GanzingerLab/K2TIRF/K2TIRF/images/K2_setup_left.jpg

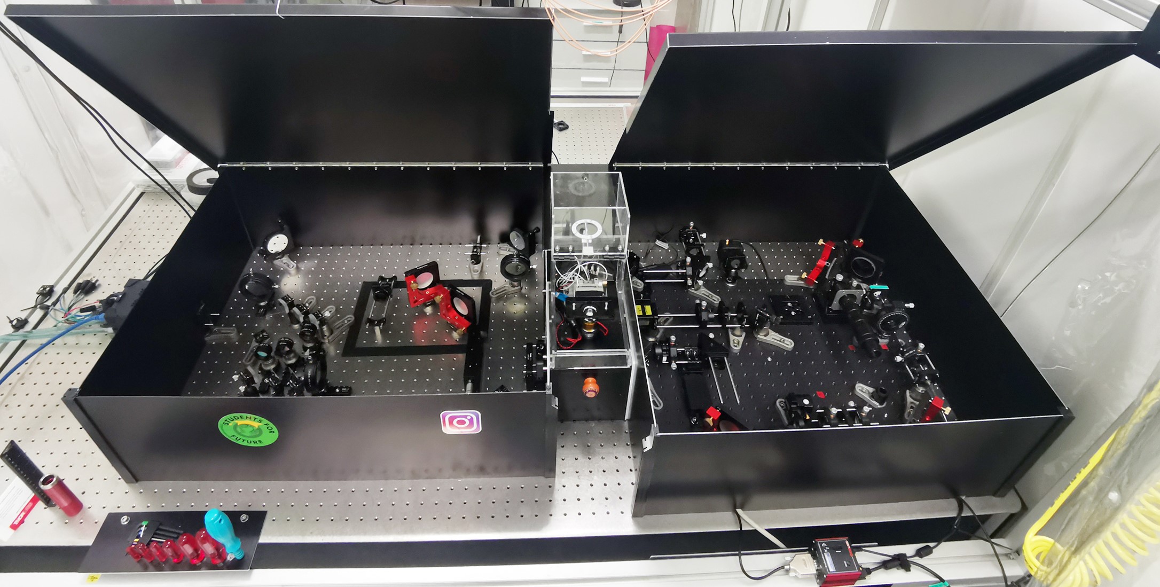
K2TIRF/images/K2_setup_left.jpg
