GanzingerLab/K2TIRF/K2TIRF/images/slideshow/fullsetup.jpg

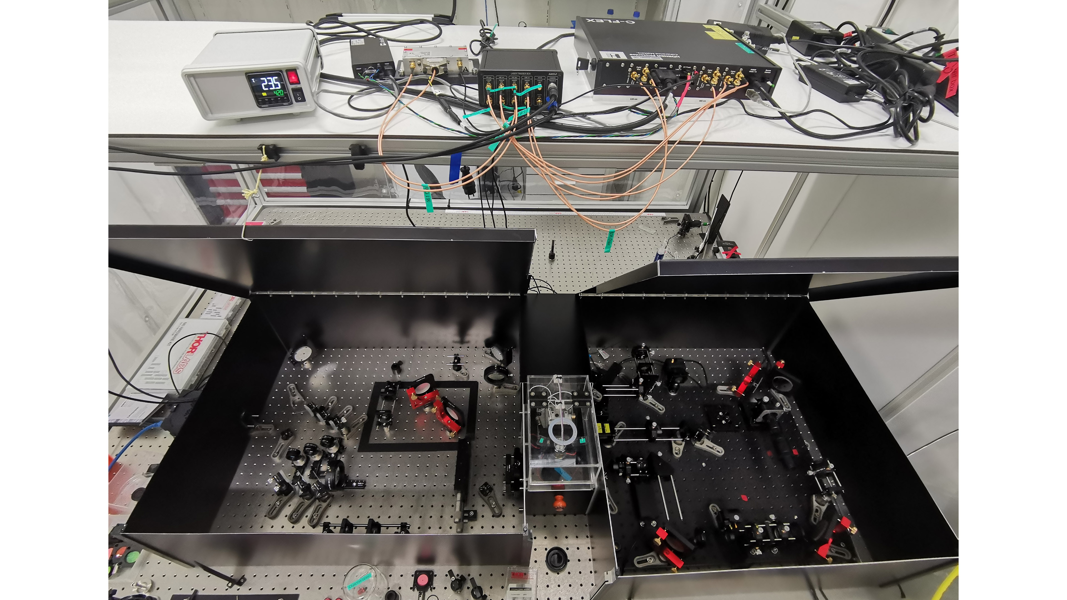
K2TIRF/images/slideshow/fullsetup.jpg
