GanzingerLab/K2TIRF/Readme.md

Home of the K2 TIRF GithubPages documents. See the site in action on https://ganzingerlab.github.io/K2TIRF/index.html.
