GanzingerLab/K2TIRF/K2TIRF/documentation/qgFocus/timer configuration.pdf

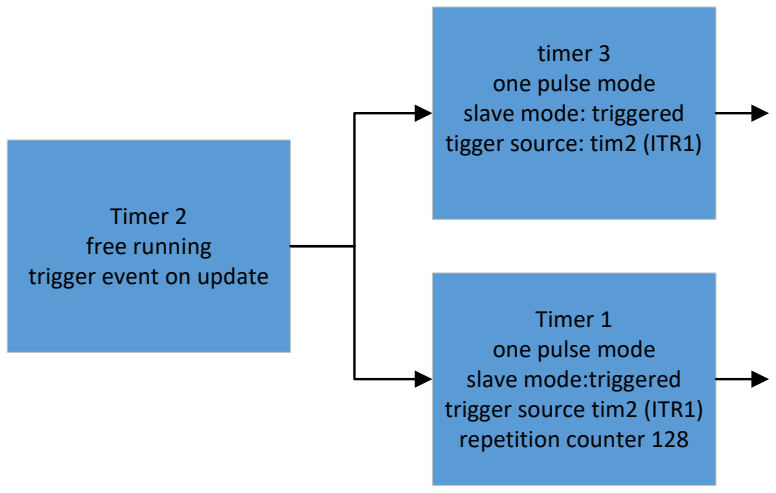
[picture p3: figure]
timer 3 one pulse mode slave mode: triggered tigger source: tim2 (ITR1); Timer 1 one pulse mode slave mode:triggered trigger source tim2 (ITR1) repetition counter 128; Timer 2 free running trigger event on update

SI

CLK

Timer 2 is free running and serves as the aquisition timer. Upon overflow of this timer, timer 3 and 1 are both triggered. Timer 3 provides the necessary SI signal for the sensor. This SI pulse is clocked through the sensors shift register by the CLK signal generated by timer 1.
