GanzingerLab/K2TIRF/K2TIRF/documentation/qgFocus/block_diagram.PNG

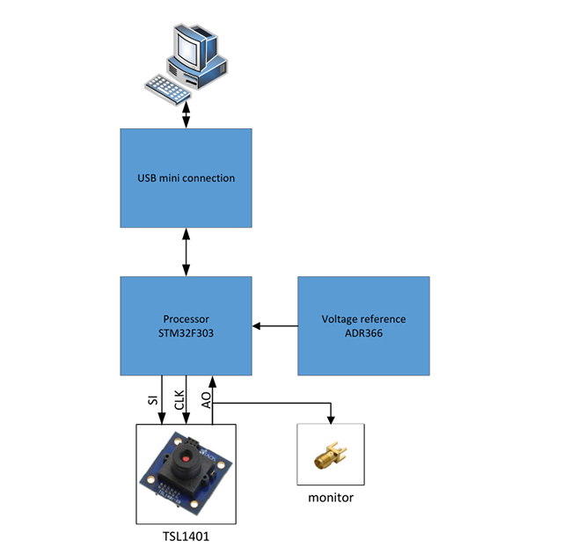
K2TIRF/documentation/qgFocus/block_diagram.PNG
