GanzingerLab/K2TIRF/K2TIRF/documentation/qgFocus/pcb.PNG

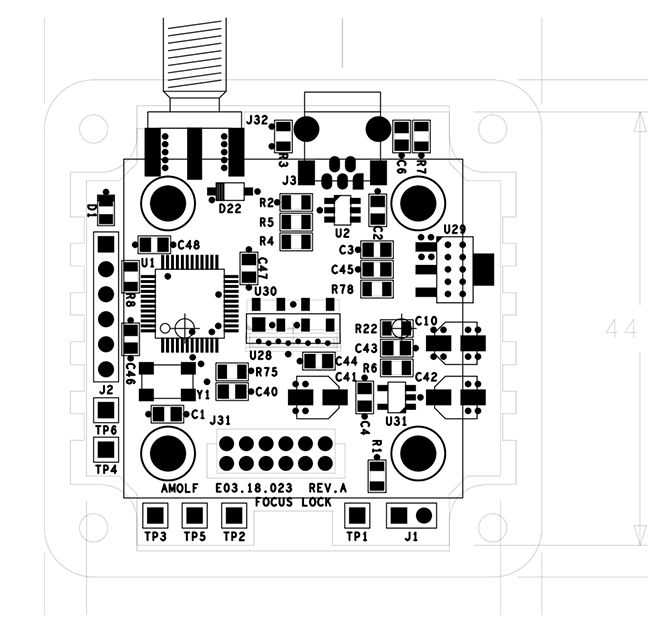
K2TIRF/documentation/qgFocus/pcb.PNG
