GanzingerLab/K2TIRF/K2TIRF/documentation/qgFocus/schematic.PNG

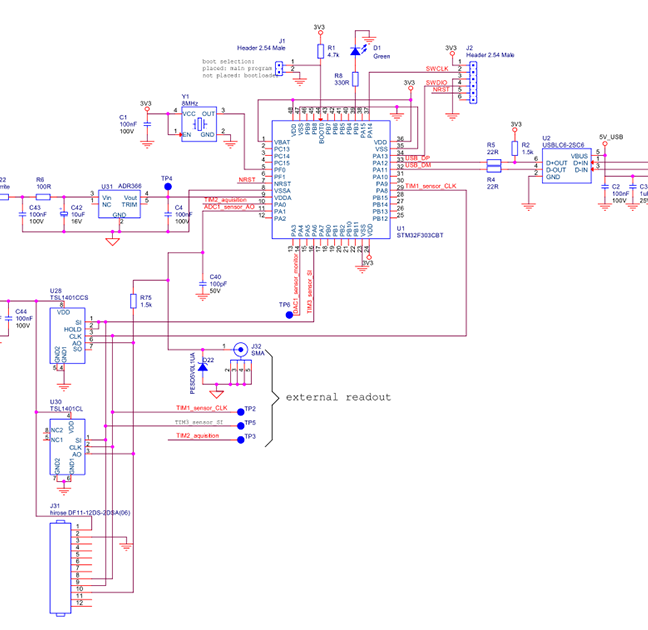
K2TIRF/documentation/qgFocus/schematic.PNG
