GanzingerLab/K2TIRF/K2TIRF/filter/box.jpg

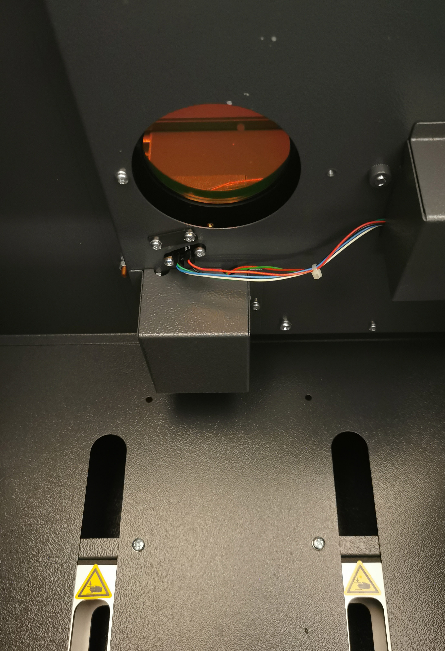
K2TIRF/filter/box.jpg
