GanzingerLab/K2TIRF/K2TIRF/filter/box_filter.jpg

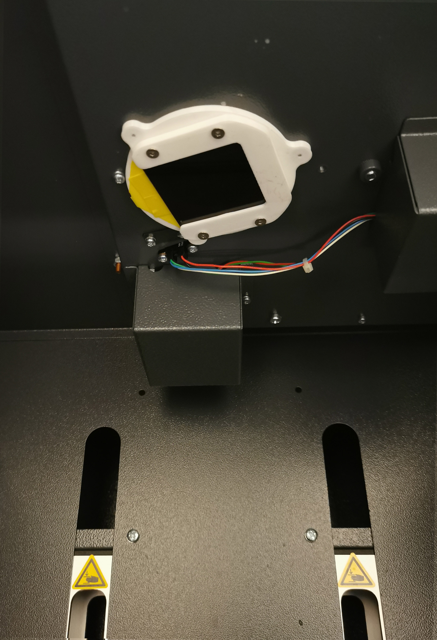
K2TIRF/filter/box_filter.jpg
