GanzingerLab/K2TIRF/K2TIRF/filter/filter.jpg

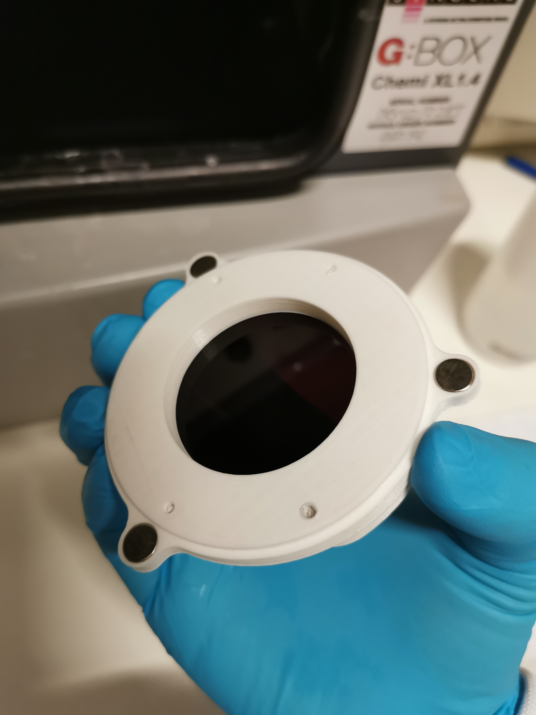
K2TIRF/filter/filter.jpg
