GanzingerLab/K2TIRF/K2TIRF/images/4fsystem.jpg

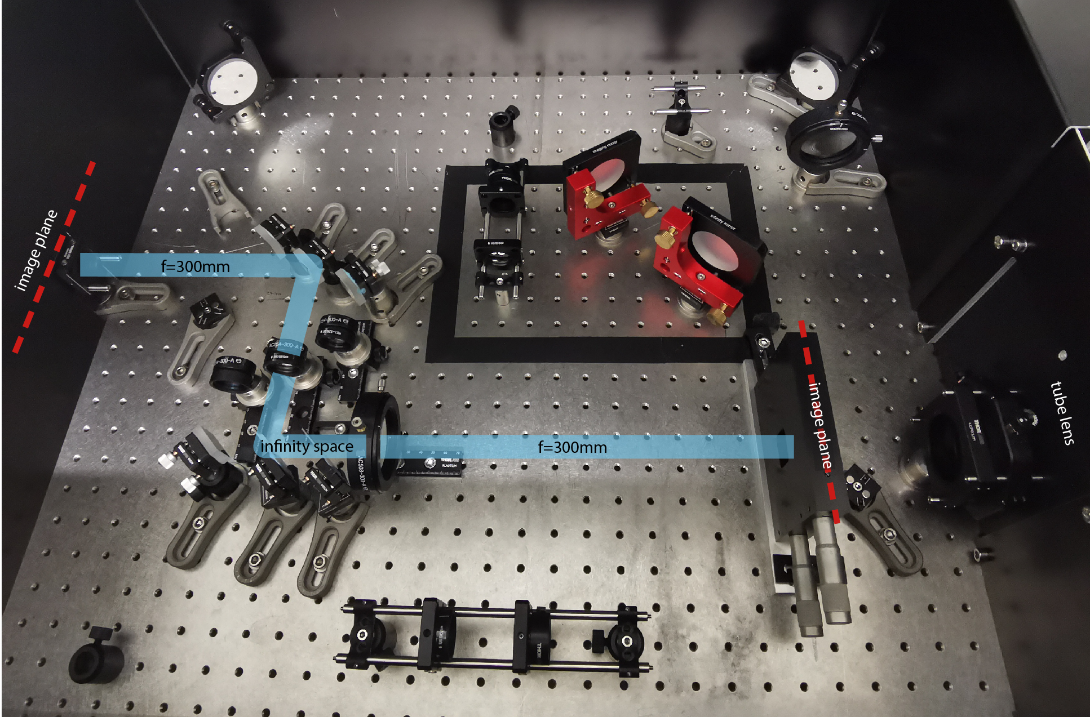
K2TIRF/images/4fsystem.jpg
