GanzingerLab/K2TIRF/K2TIRF/images/405_atto390.PNG

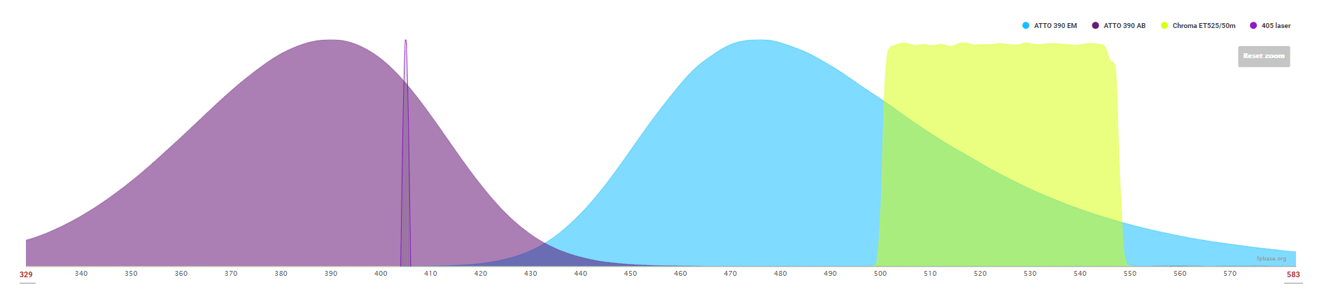
K2TIRF/images/405_atto390.PNG
