GanzingerLab/K2TIRF/K2TIRF/images/808.jpg

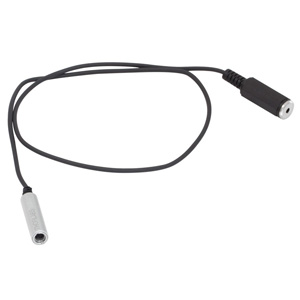
K2TIRF/images/808.jpg
