GanzingerLab/K2TIRF/K2TIRF/images/aaoptoelectronics.png

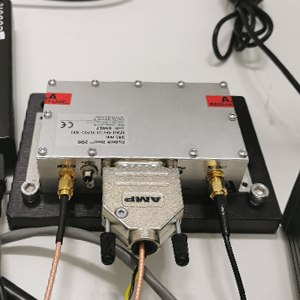
K2TIRF/images/aaoptoelectronics.png
