GanzingerLab/K2TIRF/K2TIRF/images/alignmentdisk.jpg

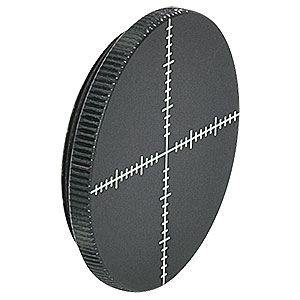
K2TIRF/images/alignmentdisk.jpg
