GanzingerLab/K2TIRF/K2TIRF/images/amolf-small.png

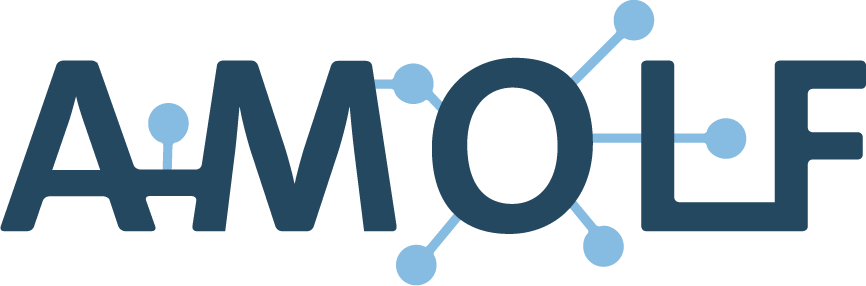
K2TIRF/images/amolf-small.png
