GanzingerLab/K2TIRF/K2TIRF/images/aperture.png

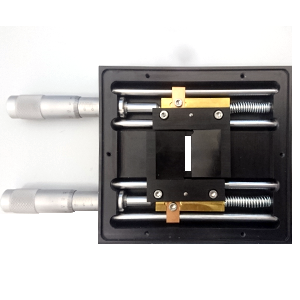
K2TIRF/images/aperture.png
