GanzingerLab/K2TIRF/K2TIRF/images/aperture_adapter.png

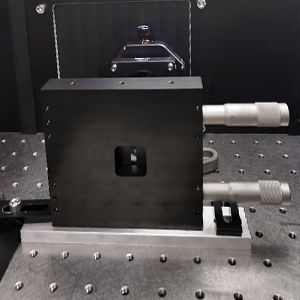
K2TIRF/images/aperture_adapter.png
