GanzingerLab/K2TIRF/K2TIRF/images/bandpass.jpg

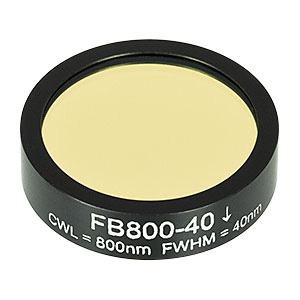
K2TIRF/images/bandpass.jpg
