GanzingerLab/K2TIRF/K2TIRF/images/beamsplitter.jpg

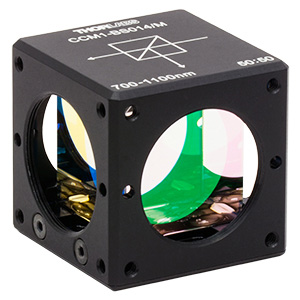
K2TIRF/images/beamsplitter.jpg
