GanzingerLab/K2TIRF/K2TIRF/images/breadboard.jpg

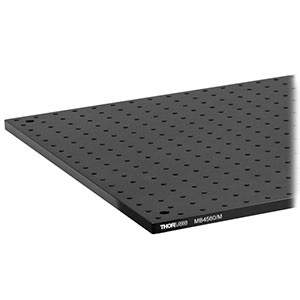
K2TIRF/images/breadboard.jpg
