GanzingerLab/K2TIRF/K2TIRF/images/cageplate2.jpg

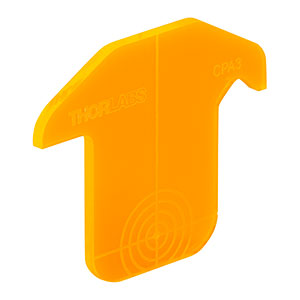
K2TIRF/images/cageplate2.jpg
