GanzingerLab/K2TIRF/K2TIRF/images/cageplate.jpg

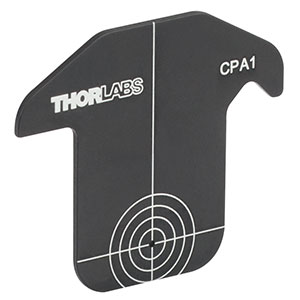
K2TIRF/images/cageplate.jpg
