GanzingerLab/K2TIRF/K2TIRF/images/cflex.png

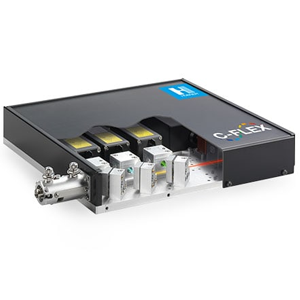
K2TIRF/images/cflex.png
