GanzingerLab/K2TIRF/K2TIRF/images/cube_amolf.png

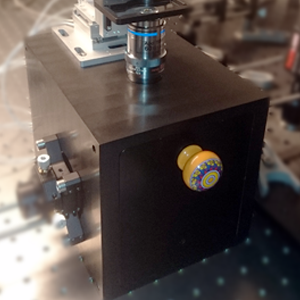
K2TIRF/images/cube_amolf.png
