GanzingerLab/K2TIRF/K2TIRF/images/cxy1.jpg

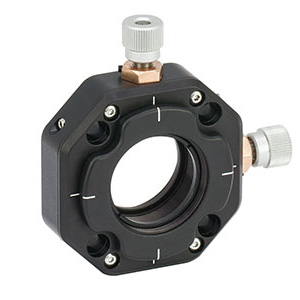
K2TIRF/images/cxy1.jpg
