GanzingerLab/K2TIRF/K2TIRF/images/dichroic_distance.png

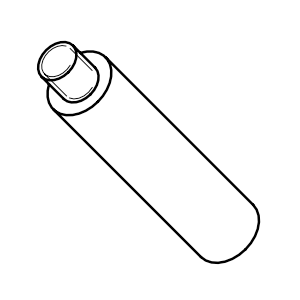
K2TIRF/images/dichroic_distance.png
