GanzingerLab/K2TIRF/K2TIRF/images/dichroic_distance_loc.png

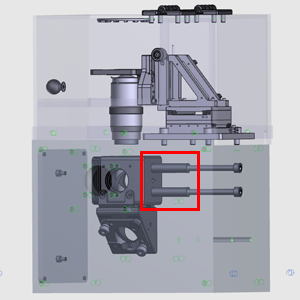
K2TIRF/images/dichroic_distance_loc.png
