GanzingerLab/K2TIRF/K2TIRF/images/dovetail.jpg

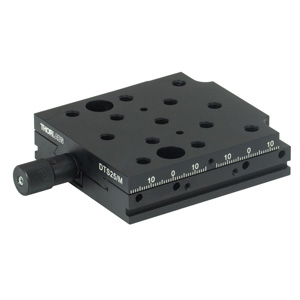
K2TIRF/images/dovetail.jpg
