GanzingerLab/K2TIRF/K2TIRF/images/emission_configurations.jpg

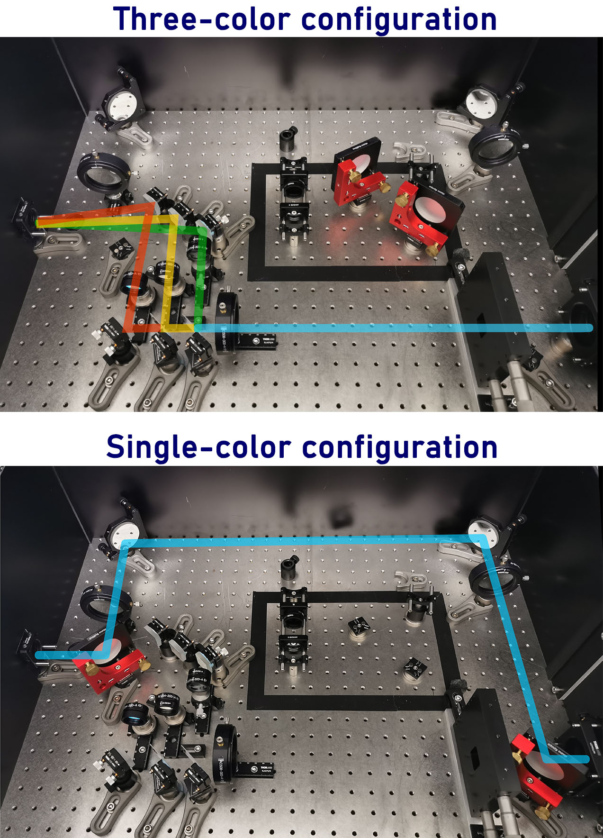
K2TIRF/images/emission_configurations.jpg
