GanzingerLab/K2TIRF/K2TIRF/images/emission_splitter.png

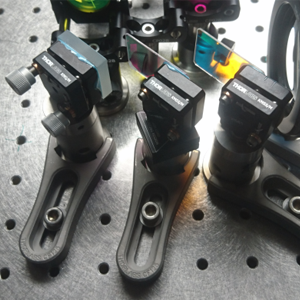
K2TIRF/images/emission_splitter.png
