GanzingerLab/K2TIRF/K2TIRF/images/emission_splitter_close.png

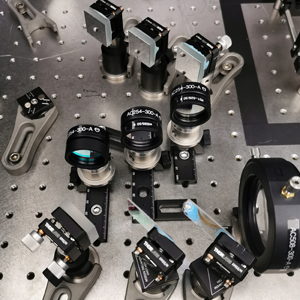
K2TIRF/images/emission_splitter_close.png
