GanzingerLab/K2TIRF/K2TIRF/images/fiber.png

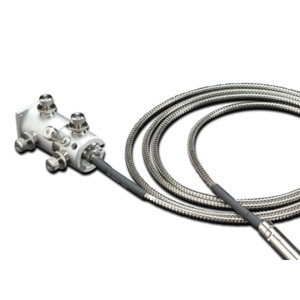
K2TIRF/images/fiber.png
