GanzingerLab/K2TIRF/K2TIRF/images/fibermount.jpg

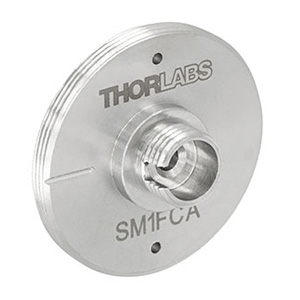
K2TIRF/images/fibermount.jpg
