GanzingerLab/K2TIRF/K2TIRF/images/flipmount.jpg

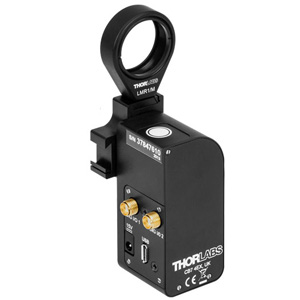
K2TIRF/images/flipmount.jpg
