GanzingerLab/K2TIRF/K2TIRF/images/fluoalignmentdisk2.jpg

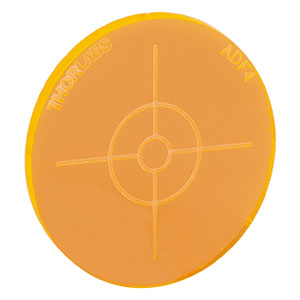
K2TIRF/images/fluoalignmentdisk2.jpg
