GanzingerLab/K2TIRF/K2TIRF/images/fluoalignmentdisk.jpg

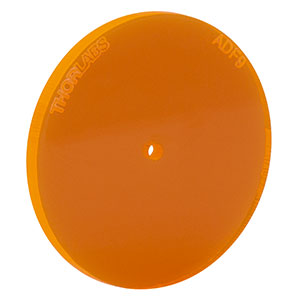
K2TIRF/images/fluoalignmentdisk.jpg
