GanzingerLab/K2TIRF/K2TIRF/images/fluoslide.jpg

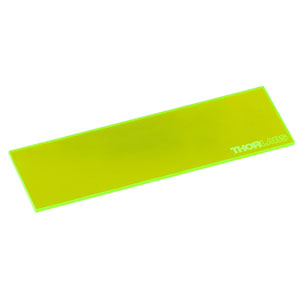
K2TIRF/images/fluoslide.jpg
