GanzingerLab/K2TIRF/K2TIRF/images/FRAP_movie.gif

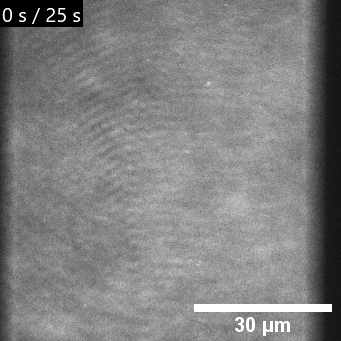
K2TIRF/images/FRAP_movie.gif
