GanzingerLab/K2TIRF/K2TIRF/images/frapmount.jpg

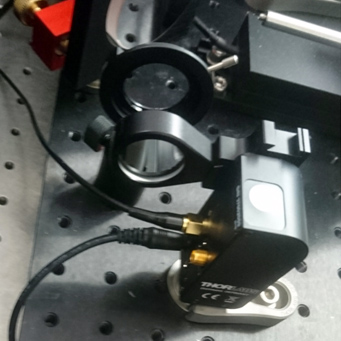
K2TIRF/images/frapmount.jpg
