GanzingerLab/K2TIRF/K2TIRF/images/gustafsson.png

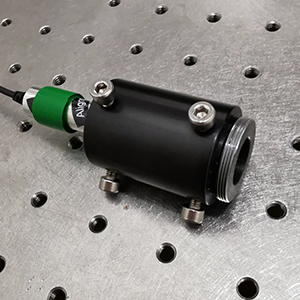
K2TIRF/images/gustafsson.png
