GanzingerLab/K2TIRF/K2TIRF/images/heatcontroller.png

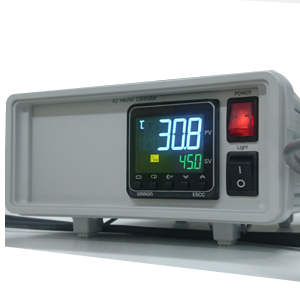
K2TIRF/images/heatcontroller.png
