GanzingerLab/K2TIRF/K2TIRF/images/heaterfoil2.png

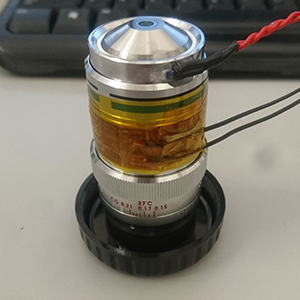
K2TIRF/images/heaterfoil2.png
