GanzingerLab/K2TIRF/K2TIRF/images/heaterfoil.png

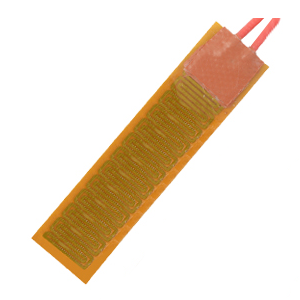
K2TIRF/images/heaterfoil.png
