GanzingerLab/K2TIRF/K2TIRF/images/housing.png

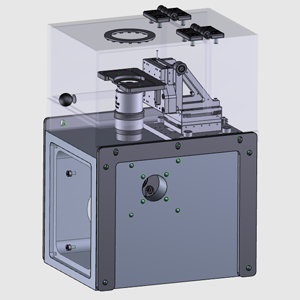
K2TIRF/images/housing.png
