GanzingerLab/K2TIRF/K2TIRF/images/IMG_20201006_183241.jpg

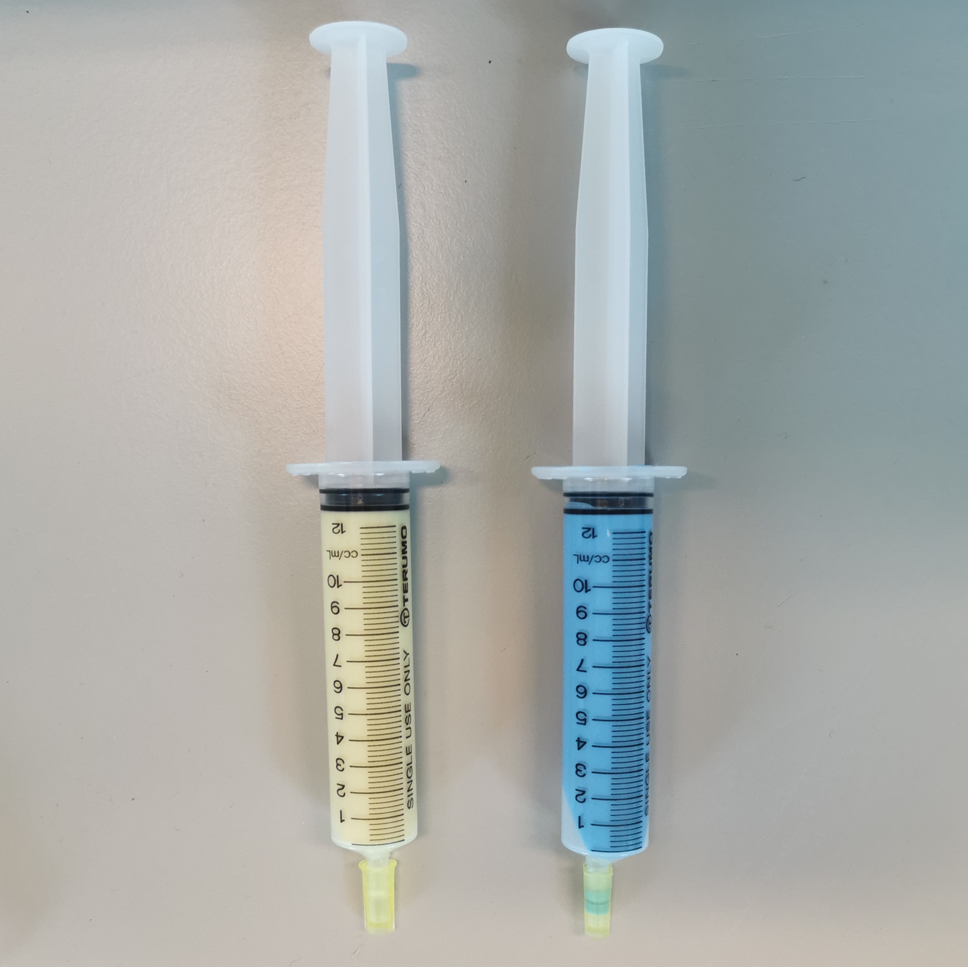
K2TIRF/images/IMG_20201006_183241.jpg
