GanzingerLab/K2TIRF/K2TIRF/images/irdisk.jpg

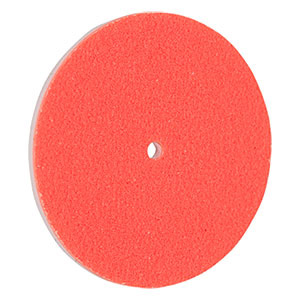
K2TIRF/images/irdisk.jpg
