GanzingerLab/K2TIRF/K2TIRF/images/irdisk_alignment.png

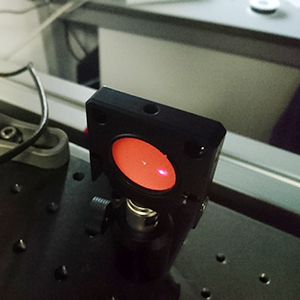
K2TIRF/images/irdisk_alignment.png
