GanzingerLab/K2TIRF/K2TIRF/images/iris.jpg

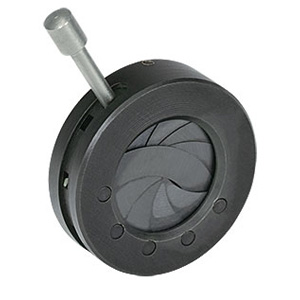
K2TIRF/images/iris.jpg
