GanzingerLab/K2TIRF/K2TIRF/images/K2_optical_path.png

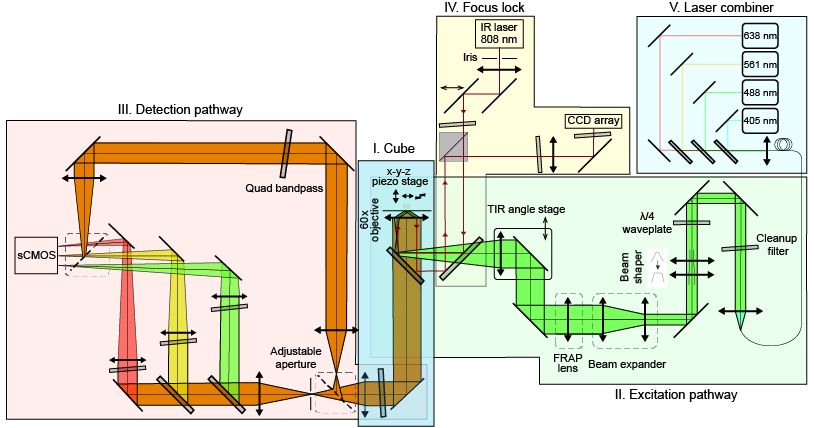
K2TIRF/images/K2_optical_path.png
