GanzingerLab/K2TIRF/K2TIRF/images/kmss.png

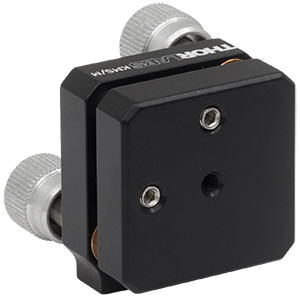
K2TIRF/images/kmss.png
