GanzingerLab/K2TIRF/K2TIRF/images/kmts25e_adapter.png

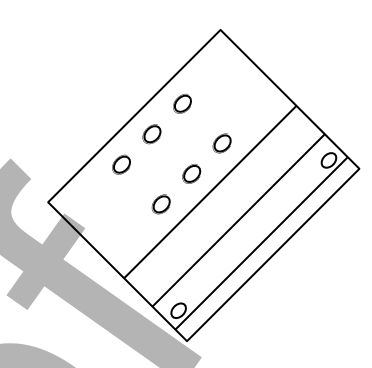
K2TIRF/images/kmts25e_adapter.png
