GanzingerLab/K2TIRF/K2TIRF/images/miCube_amolf.PNG

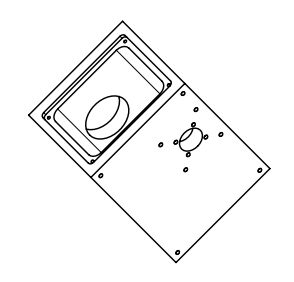
K2TIRF/images/miCube_amolf.PNG
