GanzingerLab/K2TIRF/K2TIRF/images/ne13a-b.jpg

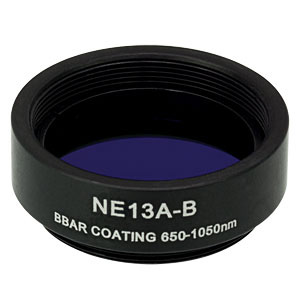
K2TIRF/images/ne13a-b.jpg
