GanzingerLab/K2TIRF/K2TIRF/images/nikon60x.png

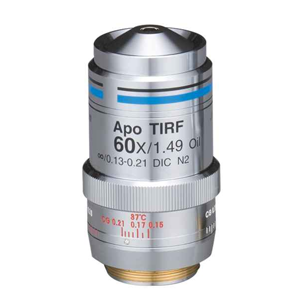
K2TIRF/images/nikon60x.png
