GanzingerLab/K2TIRF/K2TIRF/images/pishaper.png

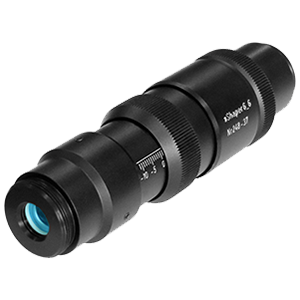
K2TIRF/images/pishaper.png
