GanzingerLab/K2TIRF/K2TIRF/images/primebsi.png

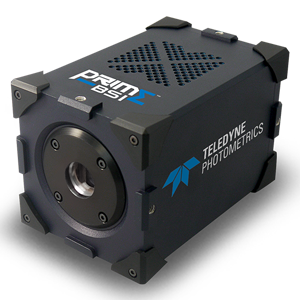
K2TIRF/images/primebsi.png
