GanzingerLab/K2TIRF/K2TIRF/images/qgfocus.png

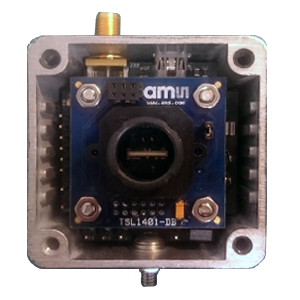
K2TIRF/images/qgfocus.png
