GanzingerLab/K2TIRF/K2TIRF/images/quadband.jpg

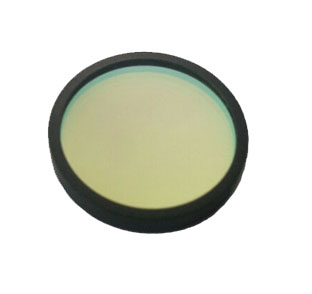
K2TIRF/images/quadband.jpg
