GanzingerLab/K2TIRF/K2TIRF/images/resolutiontarget.jpg

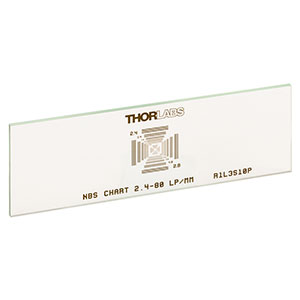
K2TIRF/images/resolutiontarget.jpg
