GanzingerLab/K2TIRF/K2TIRF/images/rotationmount.jpg

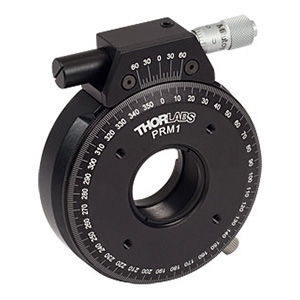
K2TIRF/images/rotationmount.jpg
