GanzingerLab/K2TIRF/K2TIRF/images/sampleholder.png

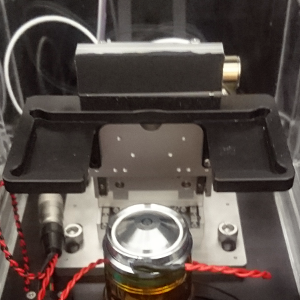
K2TIRF/images/sampleholder.png
