GanzingerLab/K2TIRF/K2TIRF/images/samples.png

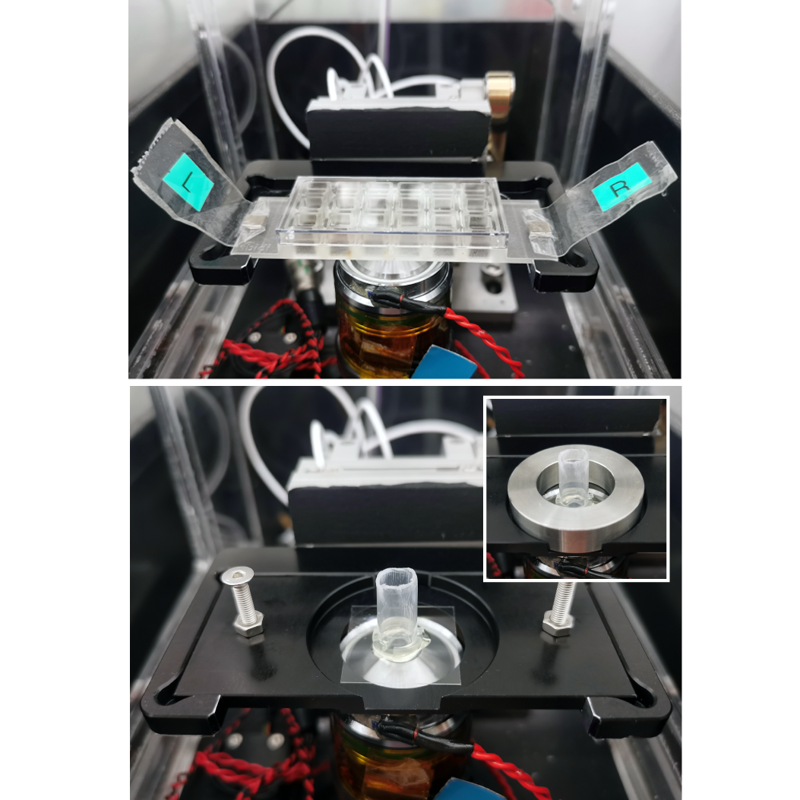
K2TIRF/images/samples.png
