GanzingerLab/K2TIRF/K2TIRF/images/shear_plate.png

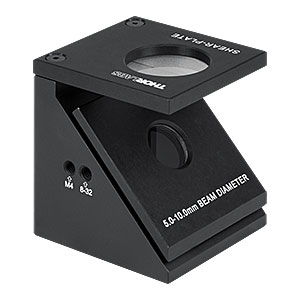
K2TIRF/images/shear_plate.png
