GanzingerLab/K2TIRF/K2TIRF/images/slideshow/aperture.jpg

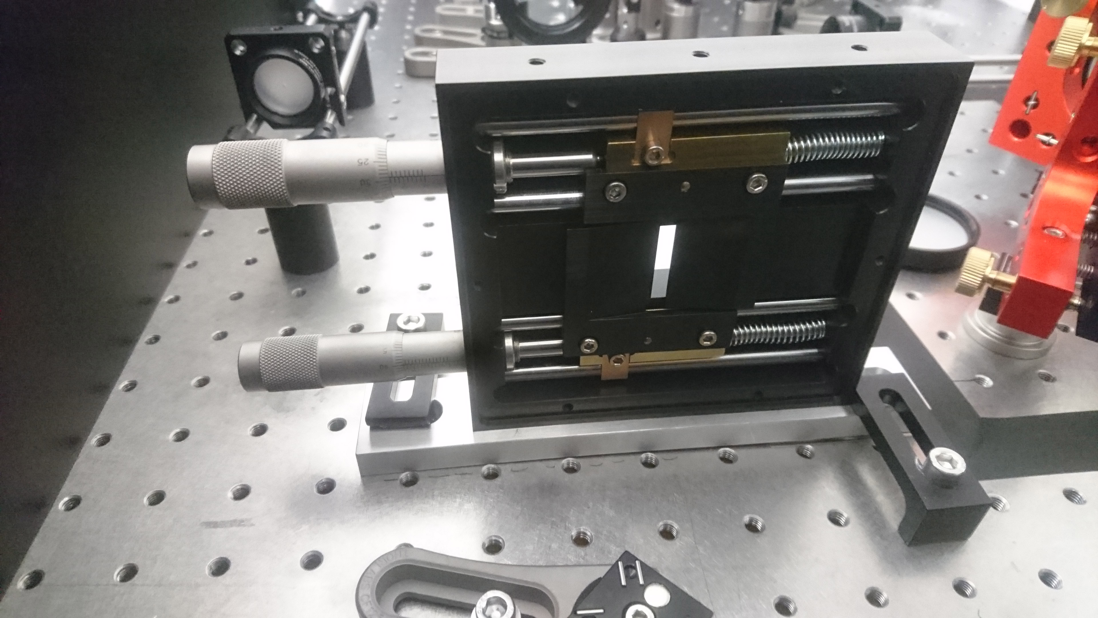
K2TIRF/images/slideshow/aperture.jpg
