GanzingerLab/K2TIRF/K2TIRF/images/slideshow/emissionpath.jpg

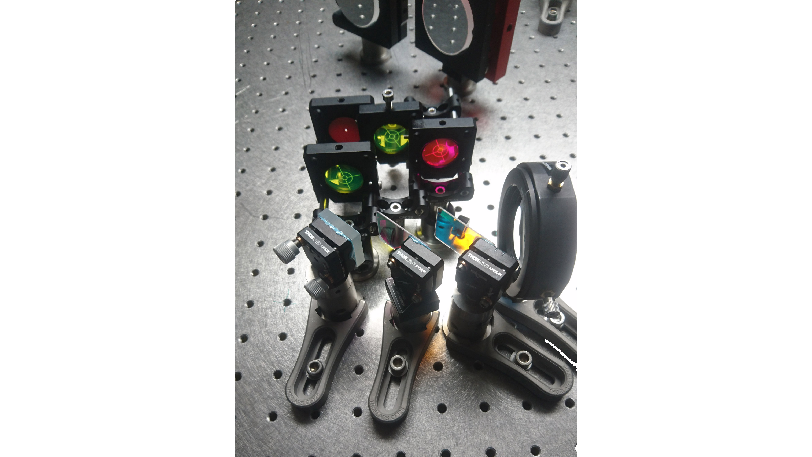
K2TIRF/images/slideshow/emissionpath.jpg
