GanzingerLab/K2TIRF/K2TIRF/images/slideshow/epi.jpg

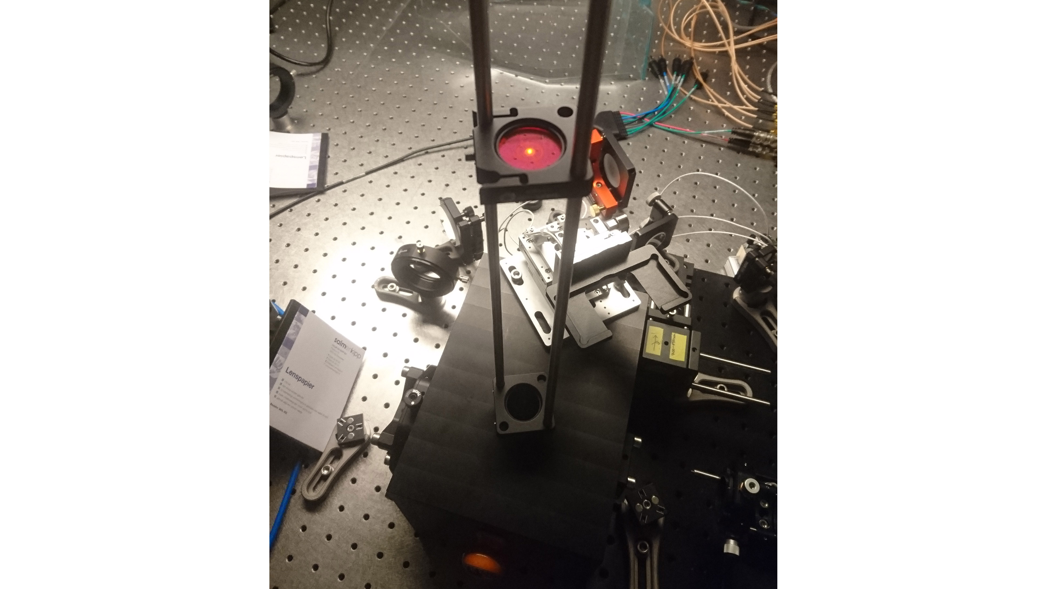
K2TIRF/images/slideshow/epi.jpg
