GanzingerLab/K2TIRF/K2TIRF/images/slideshow/excitationport.jpg

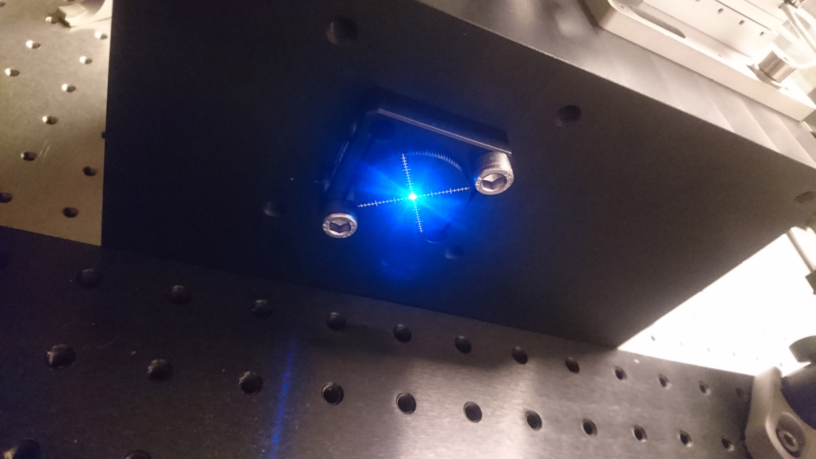
K2TIRF/images/slideshow/excitationport.jpg
