GanzingerLab/K2TIRF/K2TIRF/images/slideshow/frap.jpg

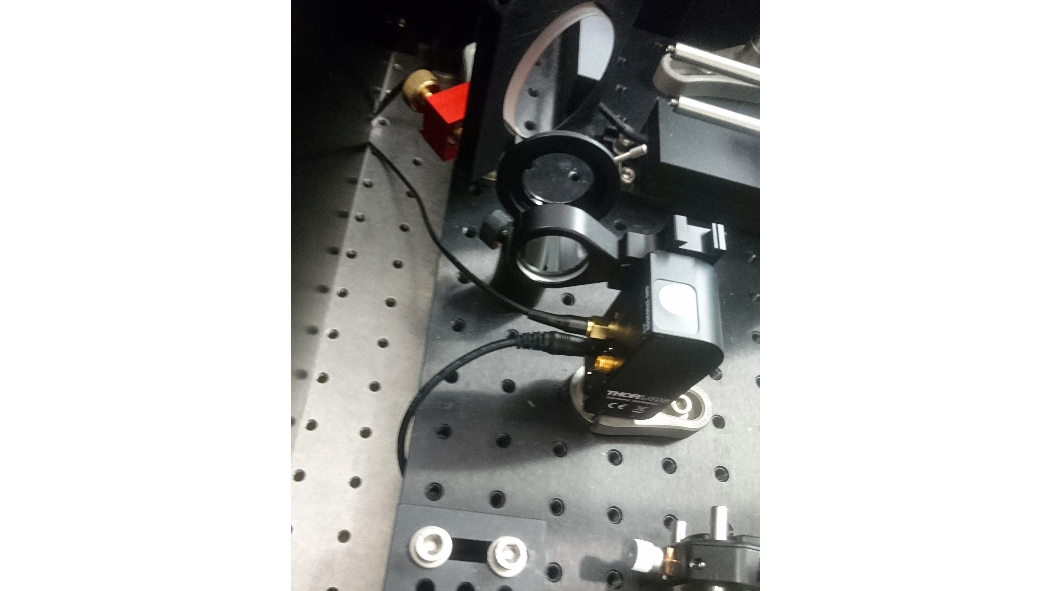
K2TIRF/images/slideshow/frap.jpg
