GanzingerLab/K2TIRF/K2TIRF/images/slideshow/labsnack.jpg

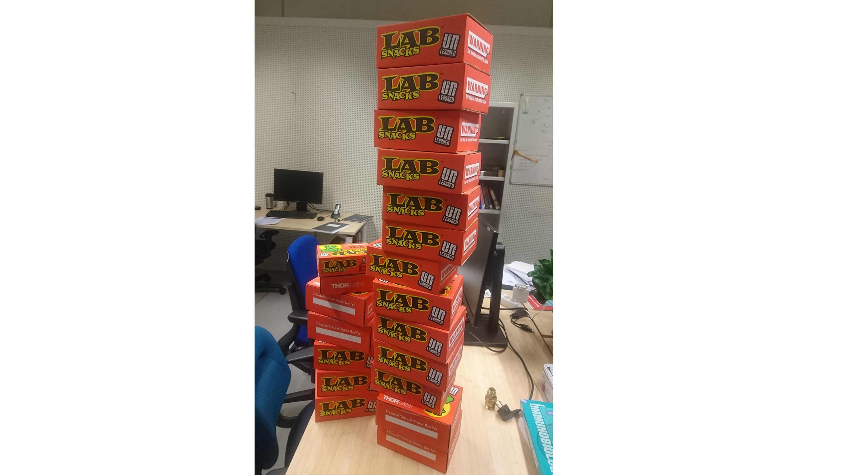
K2TIRF/images/slideshow/labsnack.jpg
