GanzingerLab/K2TIRF/K2TIRF/images/slideshow/qgfocuslock.jpg

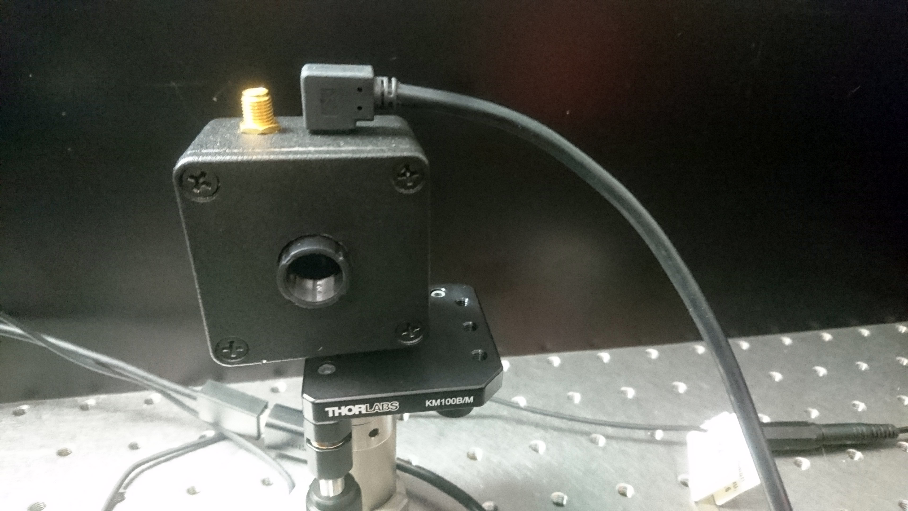
K2TIRF/images/slideshow/qgfocuslock.jpg
