GanzingerLab/K2TIRF/K2TIRF/images/slideshow/room.jpg

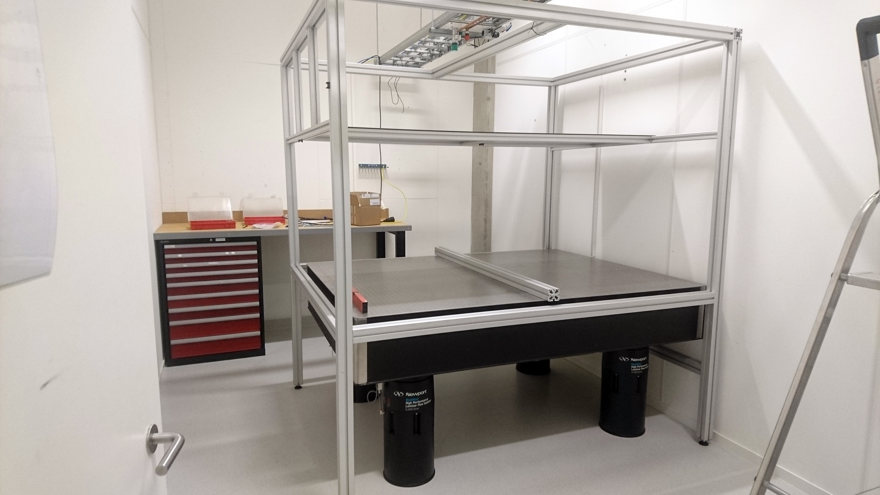
K2TIRF/images/slideshow/room.jpg
