GanzingerLab/K2TIRF/K2TIRF/images/slideshow/shear.jpg

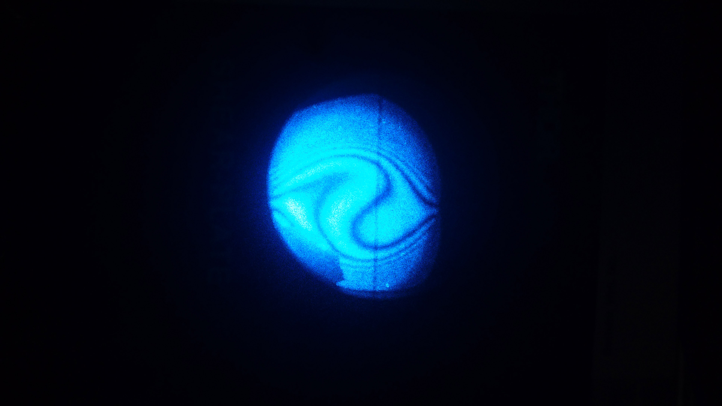
K2TIRF/images/slideshow/shear.jpg
