GanzingerLab/K2TIRF/K2TIRF/images/slideshow/software.jpg

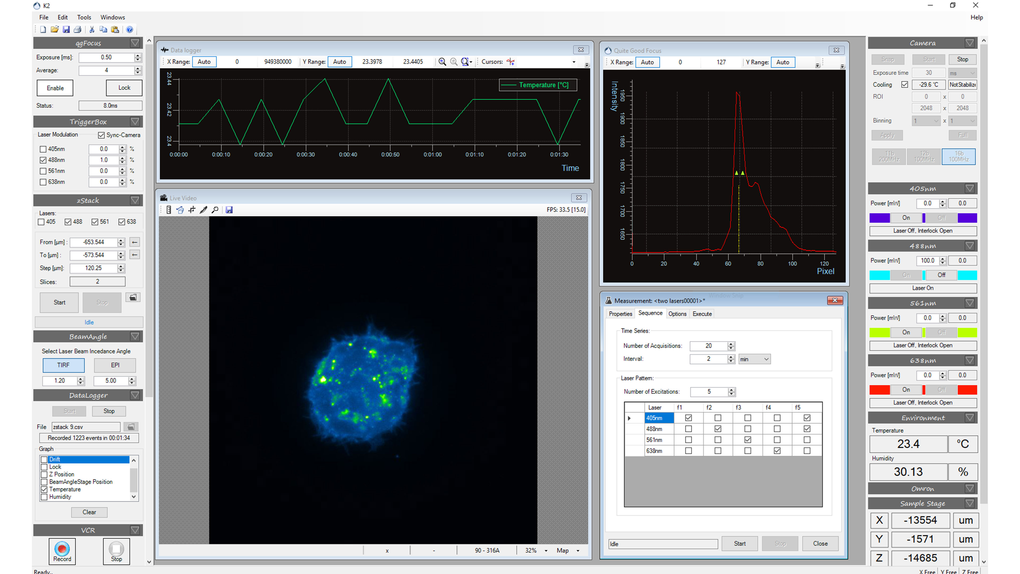
K2TIRF/images/slideshow/software.jpg
