GanzingerLab/K2TIRF/K2TIRF/images/slideshow/trigger.jpg

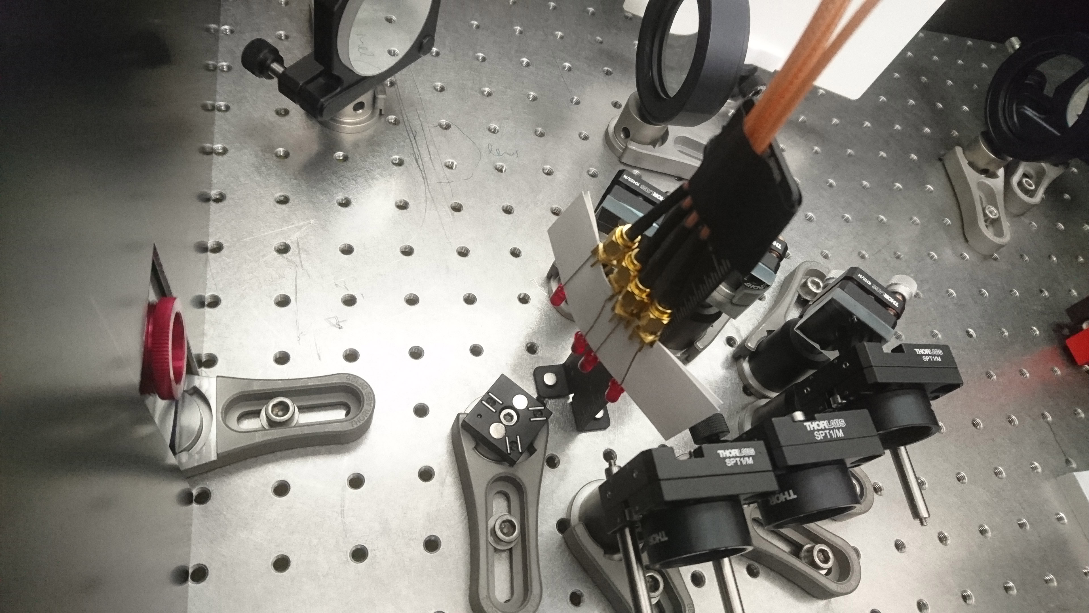
K2TIRF/images/slideshow/trigger.jpg
