GanzingerLab/K2TIRF/K2TIRF/images/slideshow/triggerbox.jpg

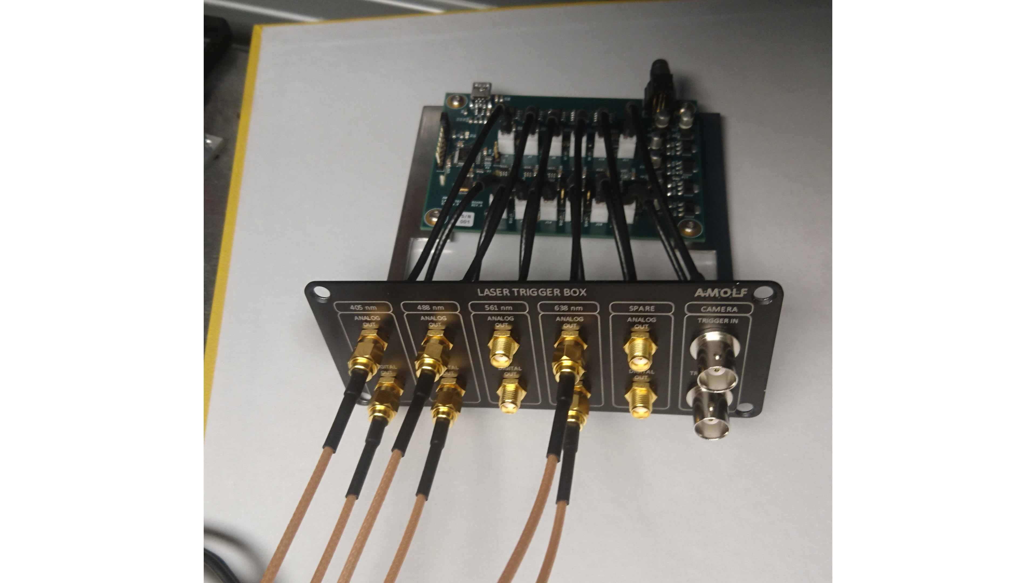
K2TIRF/images/slideshow/triggerbox.jpg
