GanzingerLab/K2TIRF/K2TIRF/images/smaract_stage.png

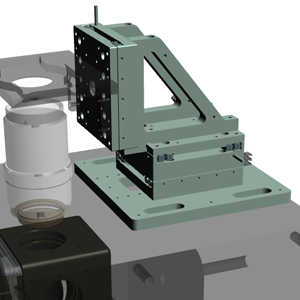
K2TIRF/images/smaract_stage.png
