GanzingerLab/K2TIRF/K2TIRF/images/stage.jpg

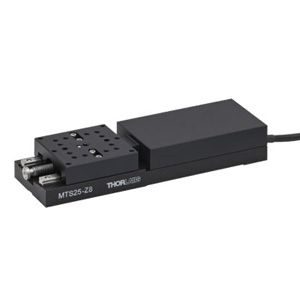
K2TIRF/images/stage.jpg
