GanzingerLab/K2TIRF/K2TIRF/images/telescope.png

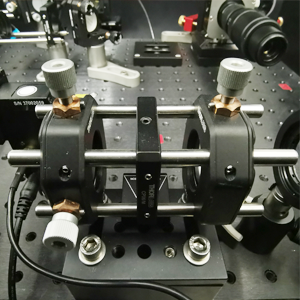
K2TIRF/images/telescope.png
