GanzingerLab/K2TIRF/K2TIRF/images/thermal_spacer2.png

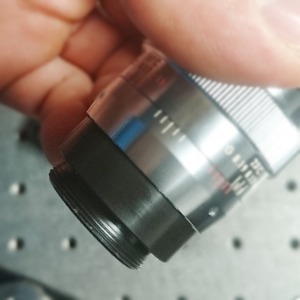
K2TIRF/images/thermal_spacer2.png
