GanzingerLab/K2TIRF/K2TIRF/images/thermal_spacer.png

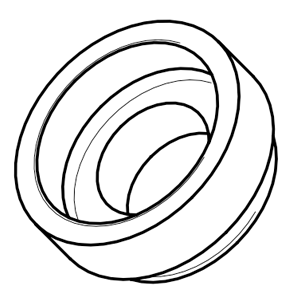
K2TIRF/images/thermal_spacer.png
