GanzingerLab/K2TIRF/K2TIRF/images/tirflens.png

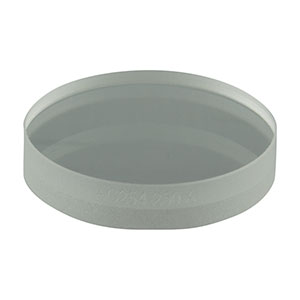
K2TIRF/images/tirflens.png
