GanzingerLab/K2TIRF/K2TIRF/images/tirflens_infra.jpg

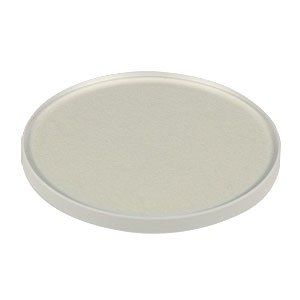
K2TIRF/images/tirflens_infra.jpg
