GanzingerLab/K2TIRF/K2TIRF/images/triggerbox.png

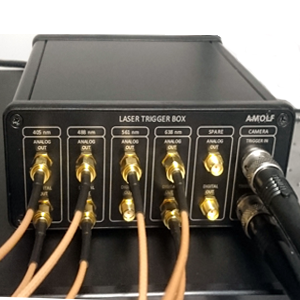
K2TIRF/images/triggerbox.png
