GanzingerLab/K2TIRF/K2TIRF/images/tubelens.png

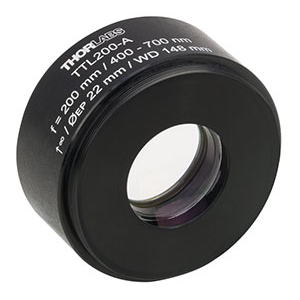
K2TIRF/images/tubelens.png
