GanzingerLab/K2TIRF/K2TIRF/documentation/qgFocus/qgFocus_components.xlsx

Quantity | Part Reference | Description | Value | Manufacturer | Manufacturer_Part_Number | PCB Footprint
10 | C1, C2, C4, C6, C43, C44, C45, C46, C47, C48 | Capacitor, Ceramic, 100V, SMD 0805 (2012), 10%, X7R | 100nF | Kemet | C0805C104K1RACTU | CAPC2012X127N
1 | C3 | Capacitor, Ceramic, 25V, SMD 0805 (2012), 10%, X5R | 1uF | Kemet | C0805C105K3PACTU | CAPC2012X127N
3 | C10, C41, C42 | Capacitor, Aluminum, 16V, SMD CASE B, 20% | 10uF | Panasonic | EEEFK1C100R | CAPAE430X540N
1 | C40 | Capacitor, Ceramic, 50V, SMD 0805 (2012), 5%, C0G | 100pF | Kemet | C0805C101J5GACTU | CAPC2012X127N
1 | D1 | LED, 0805, …V, …mA, …°, … | Green | Kingbright | KPT-2012SGC | LEDC2012X120N
1 | D22 |  | PESD5V0L1UA |  |  | SOD3818X127N
1 | J1 | Connector, Header, 2.54mm, Straight, 1-Row, 02p, Male | Header 2.54 Male | Harwin | M20-9992046 | HDR_2-54_2M
1 | J2 | Connector, Header, 2.54mm, Straight, 1-Row, 06p, Male | Header 2.54 Male | Harwin | M20-9992046 | HDR_2-54_6M
1 | J3 | Connector, USB, 2.0, Type B, Mini | USB Mini-B 2.0 | Molex | 54819-0519 | Molex_54819-0519
1 | J31 | Connector, DF11, 12p | Hirose DF11-12DS-2DSA(06) | Hirose | DF11-12DS-2DSA(06) | TSL1401DB
1 | J32 | Connector, SMA, 50-Ohm | SMA | Amphenol | 132289 | Amphenol_132289
1 | R1 | Resistor, Fixed, Thin Film, SMD 0805 (2012), 0.1W, 0.1% | 4.7k | TE Connectivity | CPF-A-0805B4K7E | RESC2012X50N
2 | R2, R75 | Resistor, Fixed, Thin Film, SMD 0805 (2012), 0.1W, 0.1% | 1.5k | TE Connectivity | CPF-A-0805B1K5E | RESC2012X50N
1 | R3 | Resistor, Fixed, Thin Film, SMD 0805 (2012), 0.1W, 0.1% | 100k | TE Connectivity | CPF-A-0805B100KE | RESC2012X50N
2 | R4, R5 | Resistor, Fixed, Thin Film, SMD 0805 (2012), 0.1W, 0.1% | 22R | TE Connectivity | CPF-A-0805B22RE | RESC2012X50N
1 | R6 | Resistor, Fixed, Thin Film, SMD 0805 (2012), 0.1W, 0.1% | 100R | TE Connectivity | CPF-A-0805B100RE | RESC2012X50N
1 | R7 | Resistor, Fixed, Thin Film, SMD 0805 (2012), 0.1W, 0.1% | 1M | TE Connectivity | CPF-A-0805B1M0E | RESC2012X50N
1 | R8 | Resistor, Fixed, Thin Film, SMD 0805 (2012), 0.1W, 0.1% | 330R | TE Connectivity | CPF-A-0805B330RE | RESC2012X50N
2 | R22, R78 | Resistor, Fixed, Thin Film, SMD 0805 (2012), 0.1W, 0.1% | ferrite | TE Connectivity | CPF-A-0805B4K7E | RESC2012X50N
6 | TP1, TP2, TP3, TP4, TP5, TP6 | Test Point, Square Pad, Width 2.54 mm | TPS100 | Harwin | M20-9992046 | HDR_2-54_1M
1 | U1 | IC, Microcontroller, 32-Bit ARM Cortex-M4, 72MHz | STM32F303CBT | ST Microelectronics | STM32F303CBT | QFP50P900X900X160-48N
1 | U2 | IC, Data-Line Protection, USB | USBLC6-2SC6 | ST Microelectronics | USBLC6-2SC6 | SOT95P284X122-6N
1 | U28 |  | TSL1401CCS |  |  | TSL1401CCS
1 | U29 | IC, Voltage Regulator, 3.3Vout, 4.5 - 15Vin, 800mA, 1.1V Drop | LD1117S33 | ST Microelectronics | LD1117S33 | SOT230P700X180-4N
1 | U30 |  | TSL1401CL |  |  | TSL1401CL
1 | U31 | voltage reference | ADR366 |  |  | SOT95P270X145-5N
1 | Y1 | Oscillator, 4-Pin, SMD, 3.3V, HCMOS, 8MHz | 8MHz | FOX Electronics | FXO-HC526R-8 | OSCCC320X500X150N
