GanzingerLab/K2TIRF/K2TIRF/documentation/qgFocus/assembly.PNG

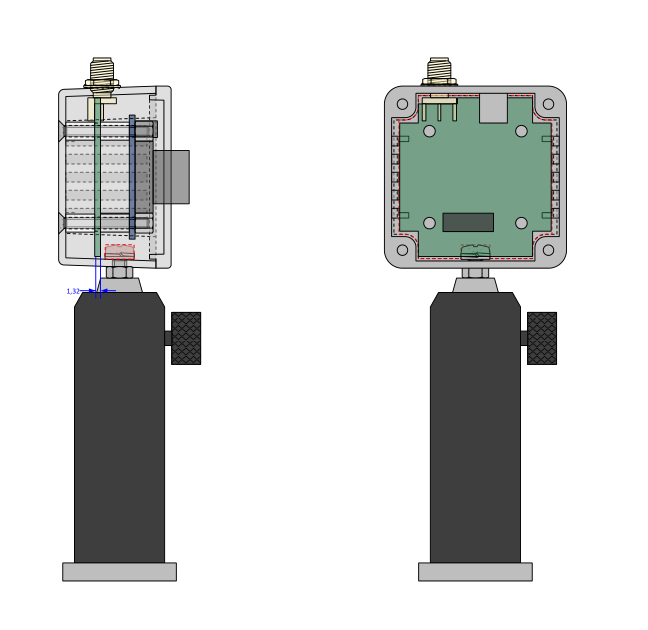
K2TIRF/documentation/qgFocus/assembly.PNG
