GanzingerLab/K2TIRF/K2TIRF/images/K2_setup_right.jpg

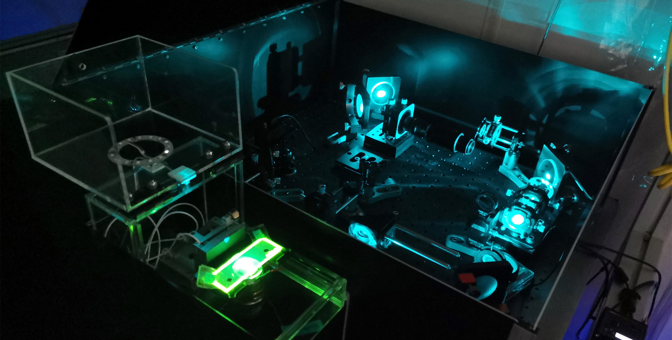
K2TIRF/images/K2_setup_right.jpg
