GanzingerLab/K2TIRF/K2TIRF/images/stageassembly.png

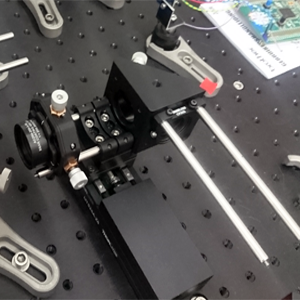
K2TIRF/images/stageassembly.png
