GanzingerLab/K2TIRF/K2TIRF/images/tubelens_assembly.png

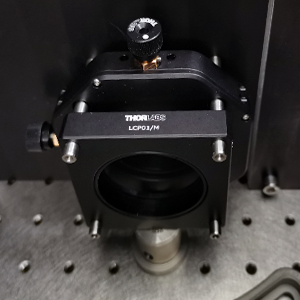
K2TIRF/images/tubelens_assembly.png
