GanzingerLab/K2TIRF/K2TIRF/images/calibration_sensor.png

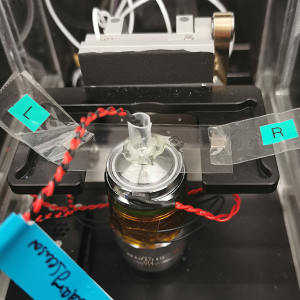
K2TIRF/images/calibration_sensor.png
