GanzingerLab/K2TIRF/K2TIRF/images/resultFRAP.png

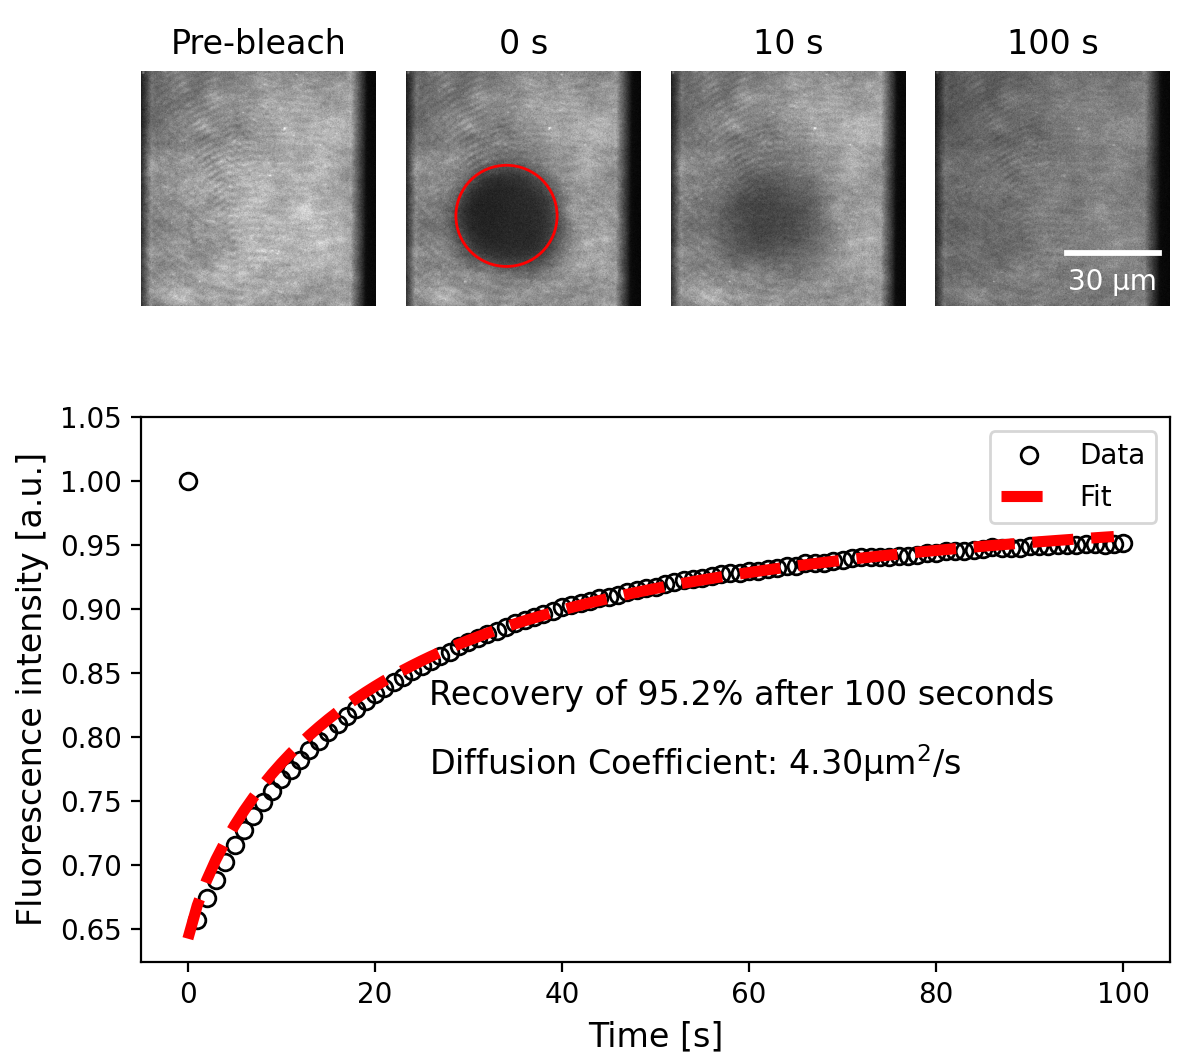
K2TIRF/images/resultFRAP.png
