GanzingerLab/K2TIRF/K2TIRF/drawings/housing_assembly.pdf

06

03

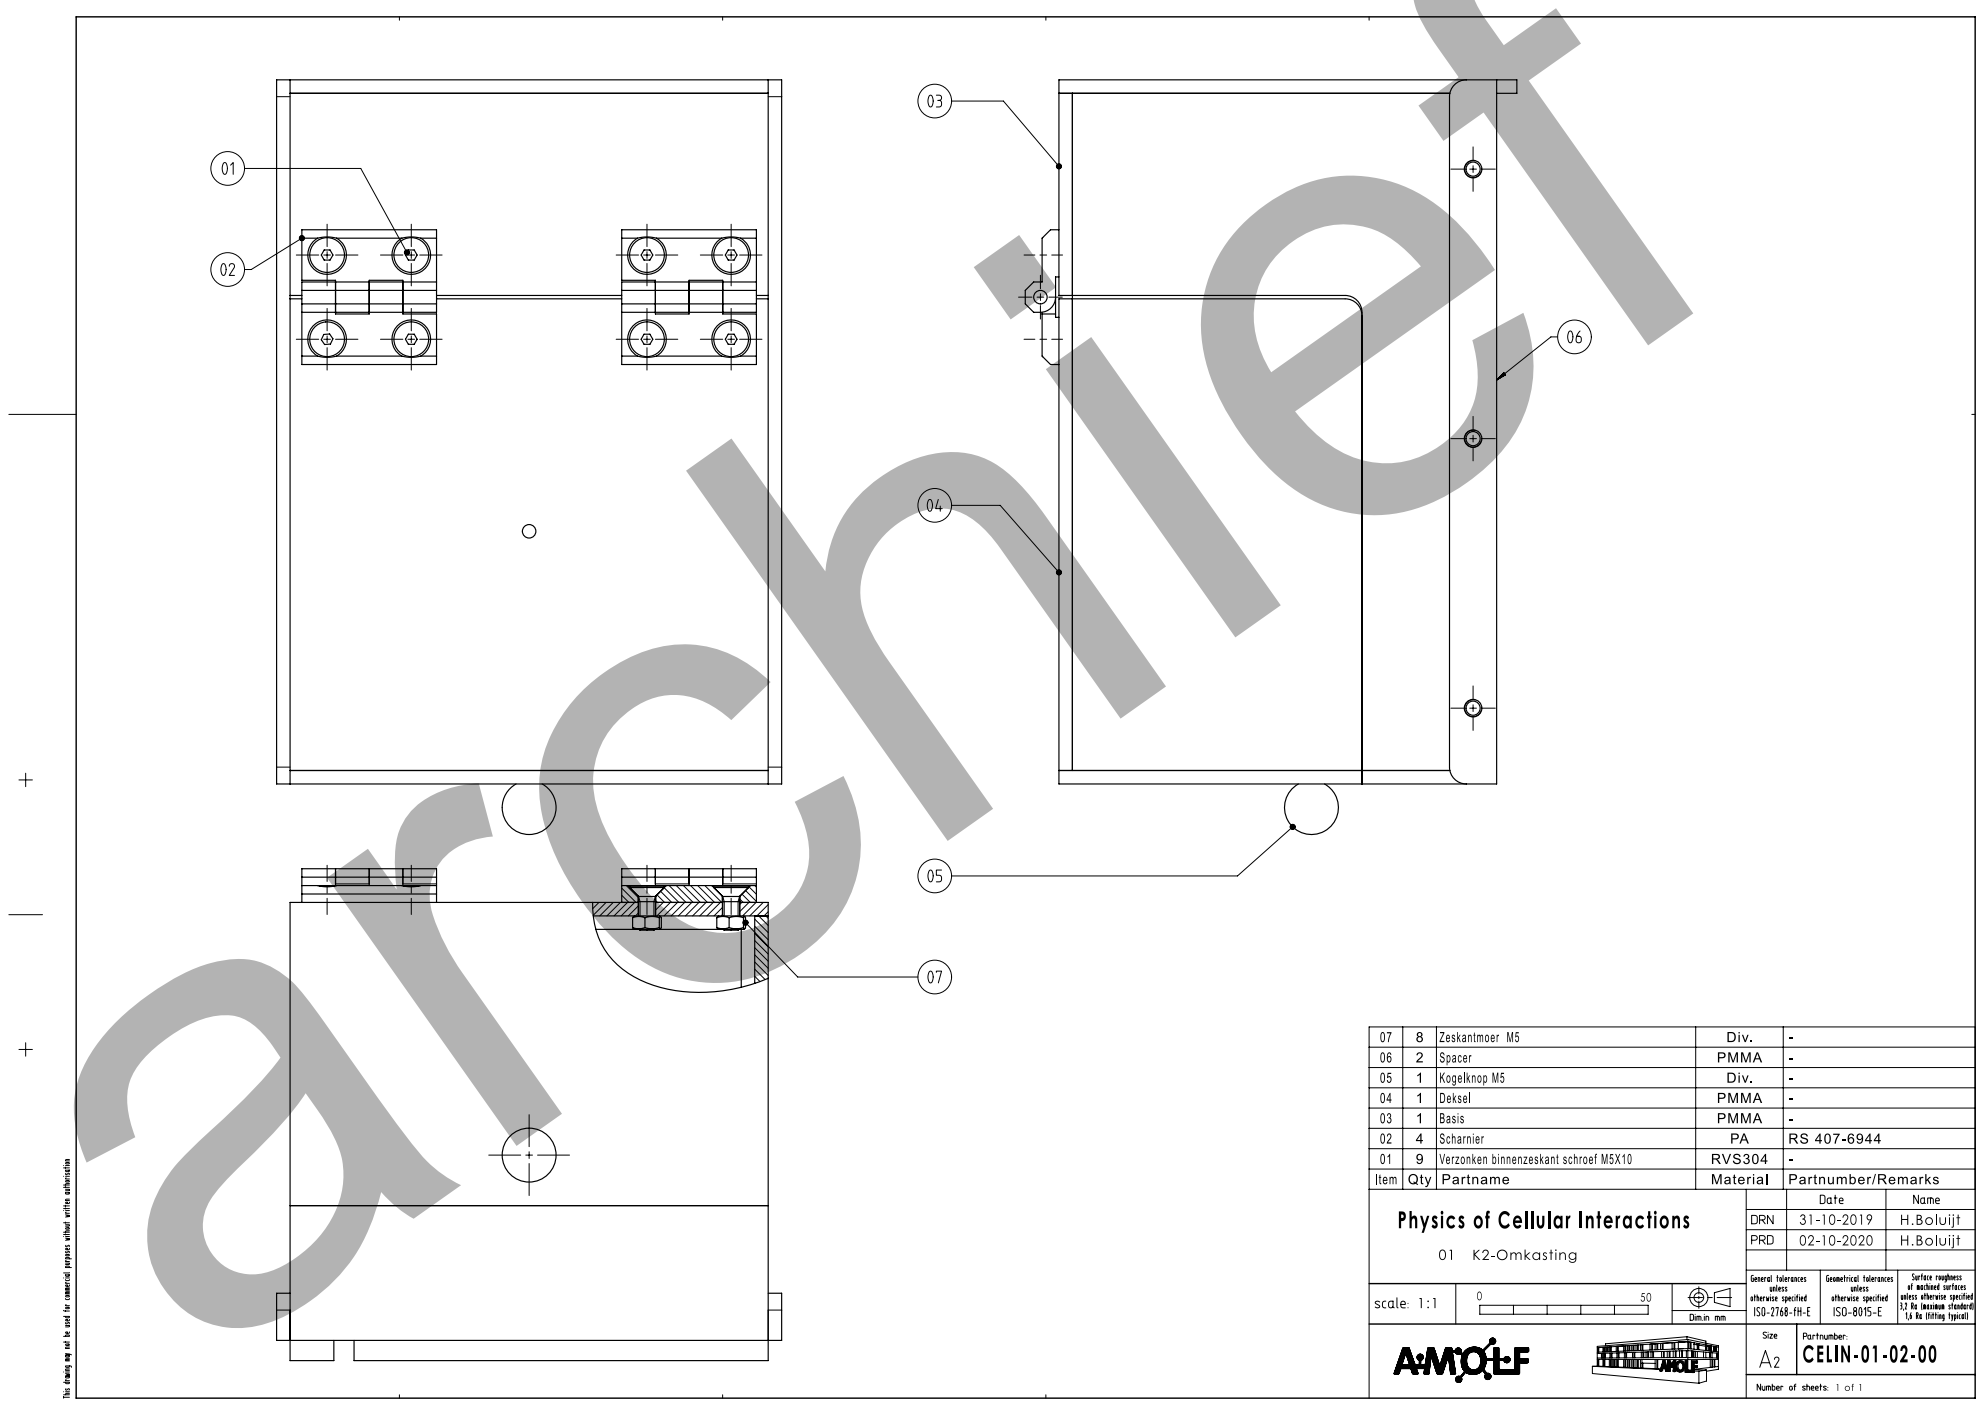
[picture p95: page 1]
Size A; Partnumber:; DRN; PRD; Date; Name; ISO-2768-fH-E; ISO-8015-E; Geometrical tolerances unless otherwise specified; General tolerances unless otherwise specified; scale:; 8 Zeskantmoer M5; Div.; 2 Spacer; PMMA; 1 Kogelknop M5; 1 Deksel; 1 Basis; Scharnier; 9 Verzonken binnenzeskant schroef M5X10; RVS304; Item Qty Partname; Material; Partnumber/Remarks; H.Boluijt; Physics of Cellular Interactions; CELIN-01-02-00; K2-Omkasting; 07 archief

This drawing may not be used for commercial purposes without written authorisation

Surface roughness
of machined surfaces
unless otherwise specified
3,2 Ra (maximum standard)
1,6 Ra (fitting typical)

Dim.in mm

Number of sheets:
