GanzingerLab/K2TIRF/K2TIRF/drawings/assembly.pdf

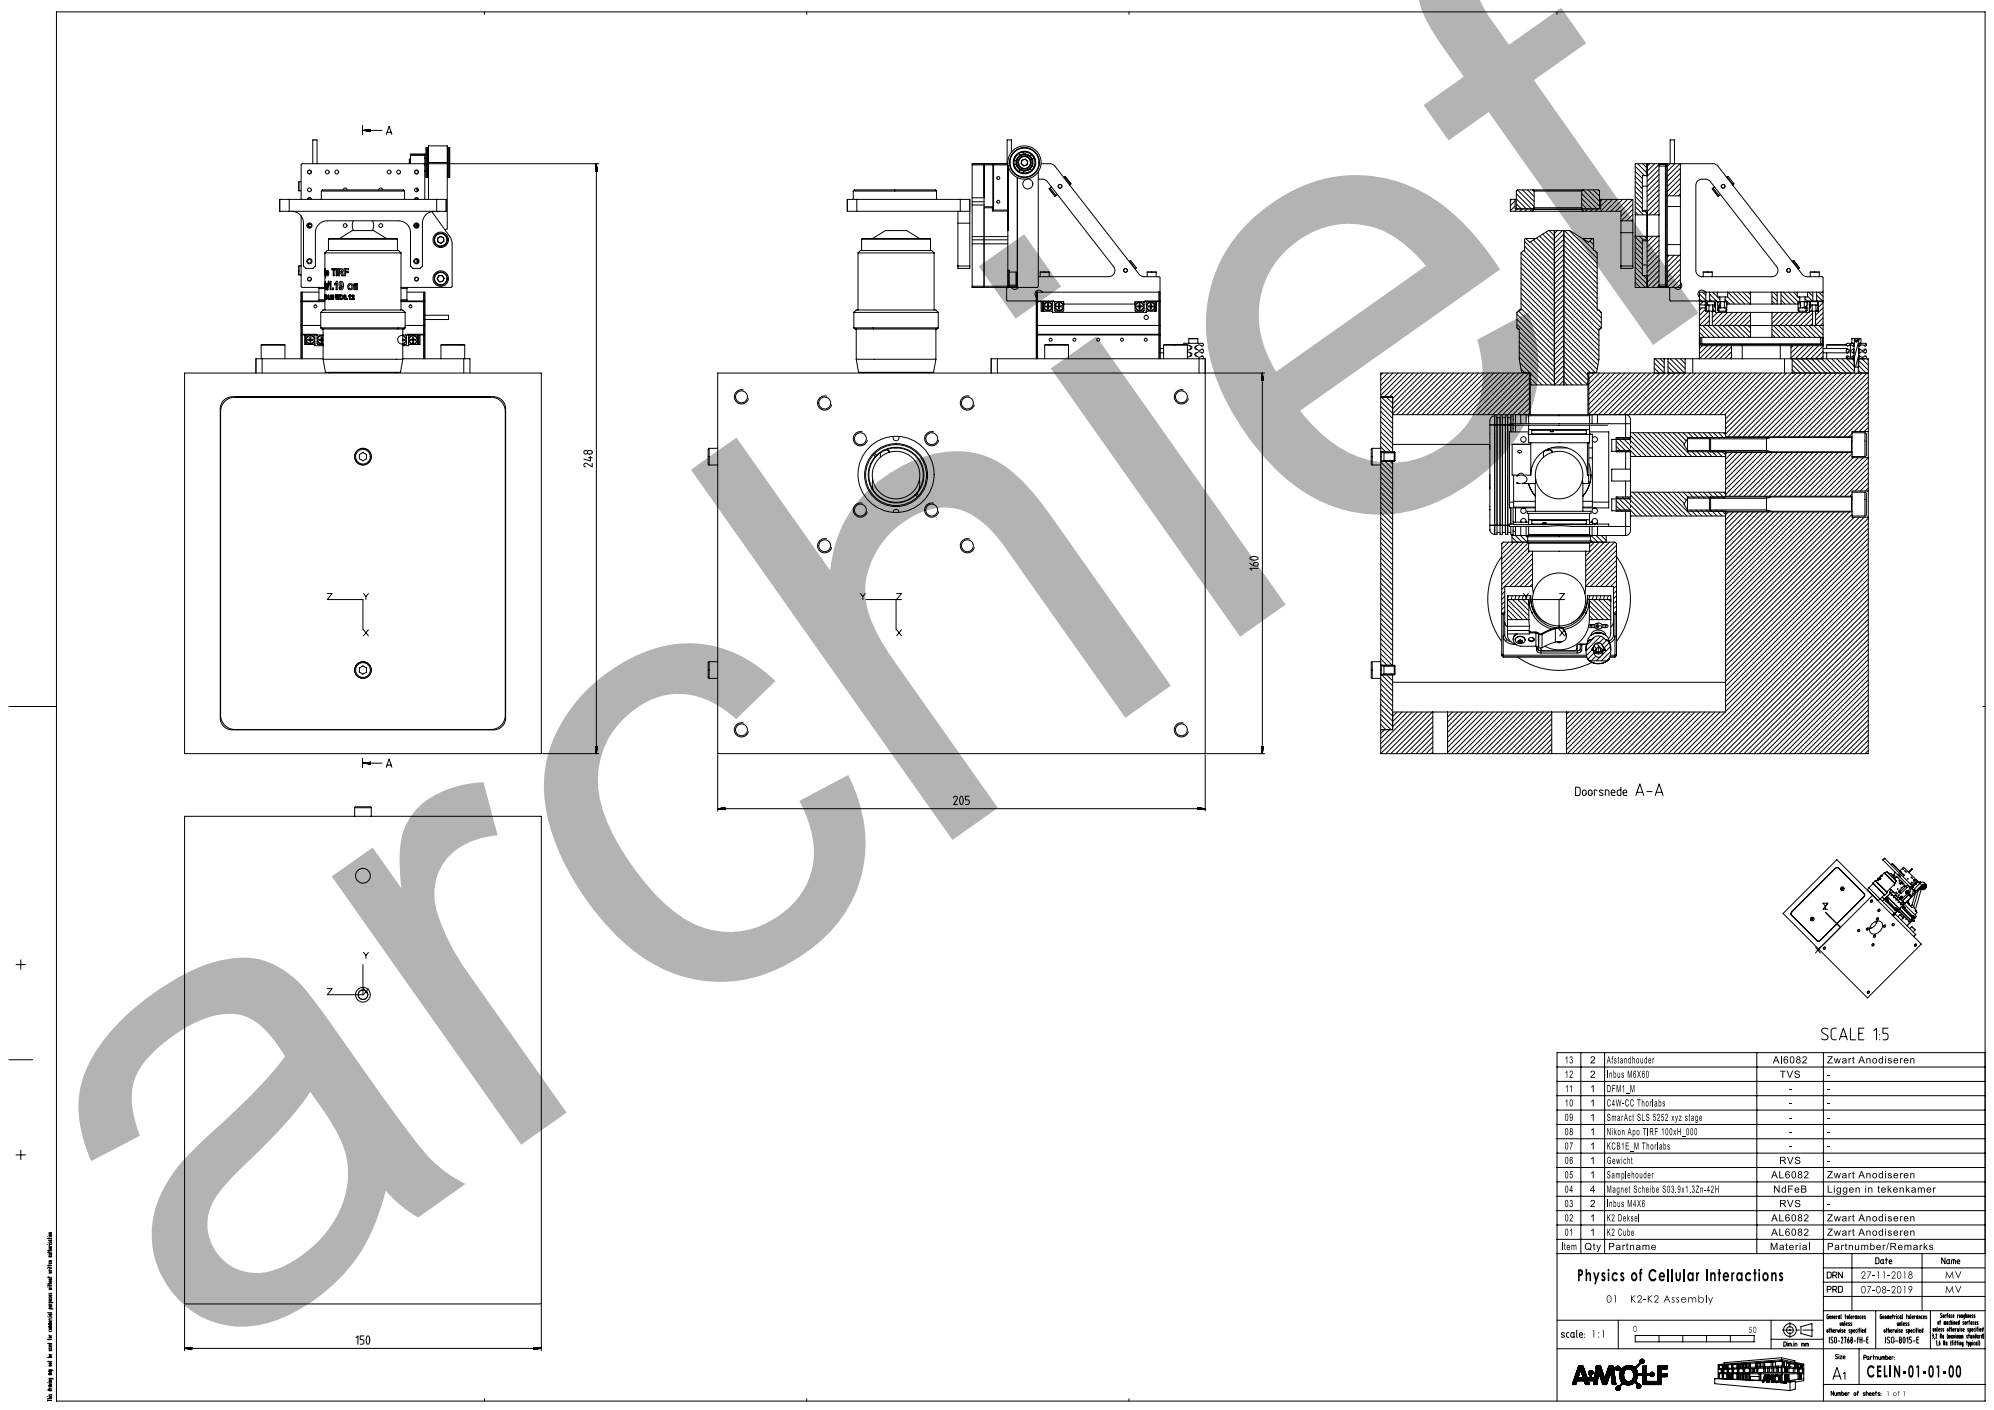
[picture p96: page 1]
Size A; Partnumber:; DRN; PRD; Date; Name; ISO-2768-fH-E; ISO-8015-E; Geometrical tolerances unless otherwise specified; General tolerances unless otherwise specified; scale:; 2 Afstandhouder; Zwart Anodiseren; Inbus M6X60; TVS; 1 DFM1_M; 1 C4W-CC Thorlabs; 1 SmarAct SLS 5252 xyz stage; 1 Nikon Apo TIRF 100xH_000; 1 KCB1E_M Thorlabs; 1 Gewicht; RVS; 1 Samplehouder; Magnet Scheibe S03.9x1.3Zn-42H; NdFeB; Liggen in tekenkamer; Inbus M4X6; 1 K2 Deksel; 1 K2 Cube; Item Qty Partname; Material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

Physics of Cellular Interactions

This drawing may not be used for commercial purposes without written authorisation

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

Dim.in mm

Number of sheets:
