GanzingerLab/K2TIRF/K2TIRF/documentation/qgFocus/E03_18_023_K2FocusLock_schematic.pdf

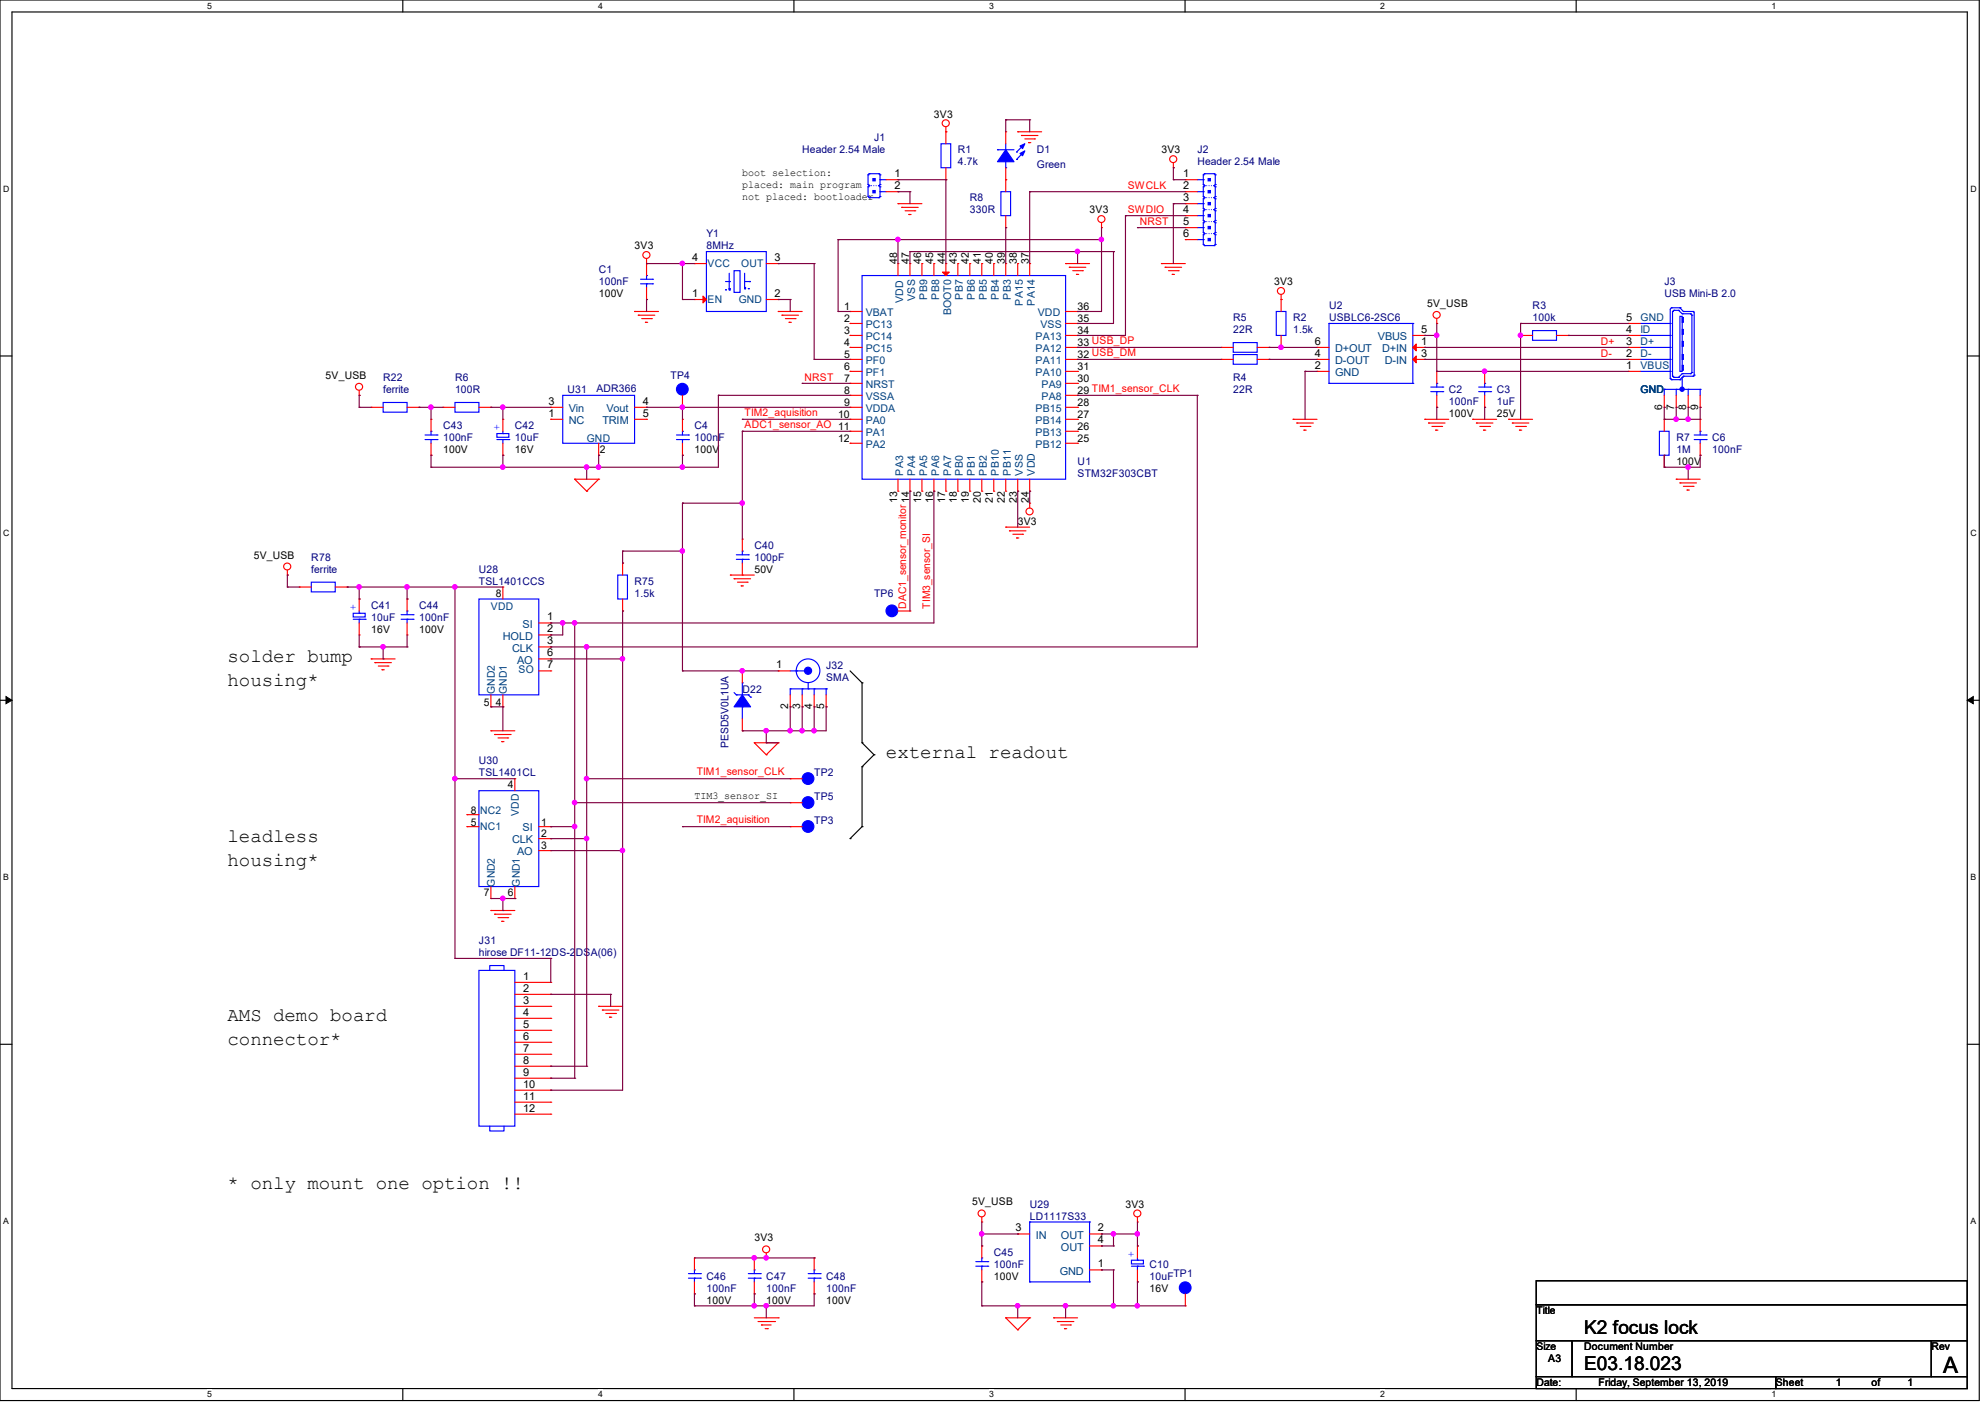
[picture p97: page 1]

* only mount one option !!
