GanzingerLab/K2TIRF/K2TIRF/documentation/qgFocus/Mechanical_Hammond 1590LLBBK.pdf

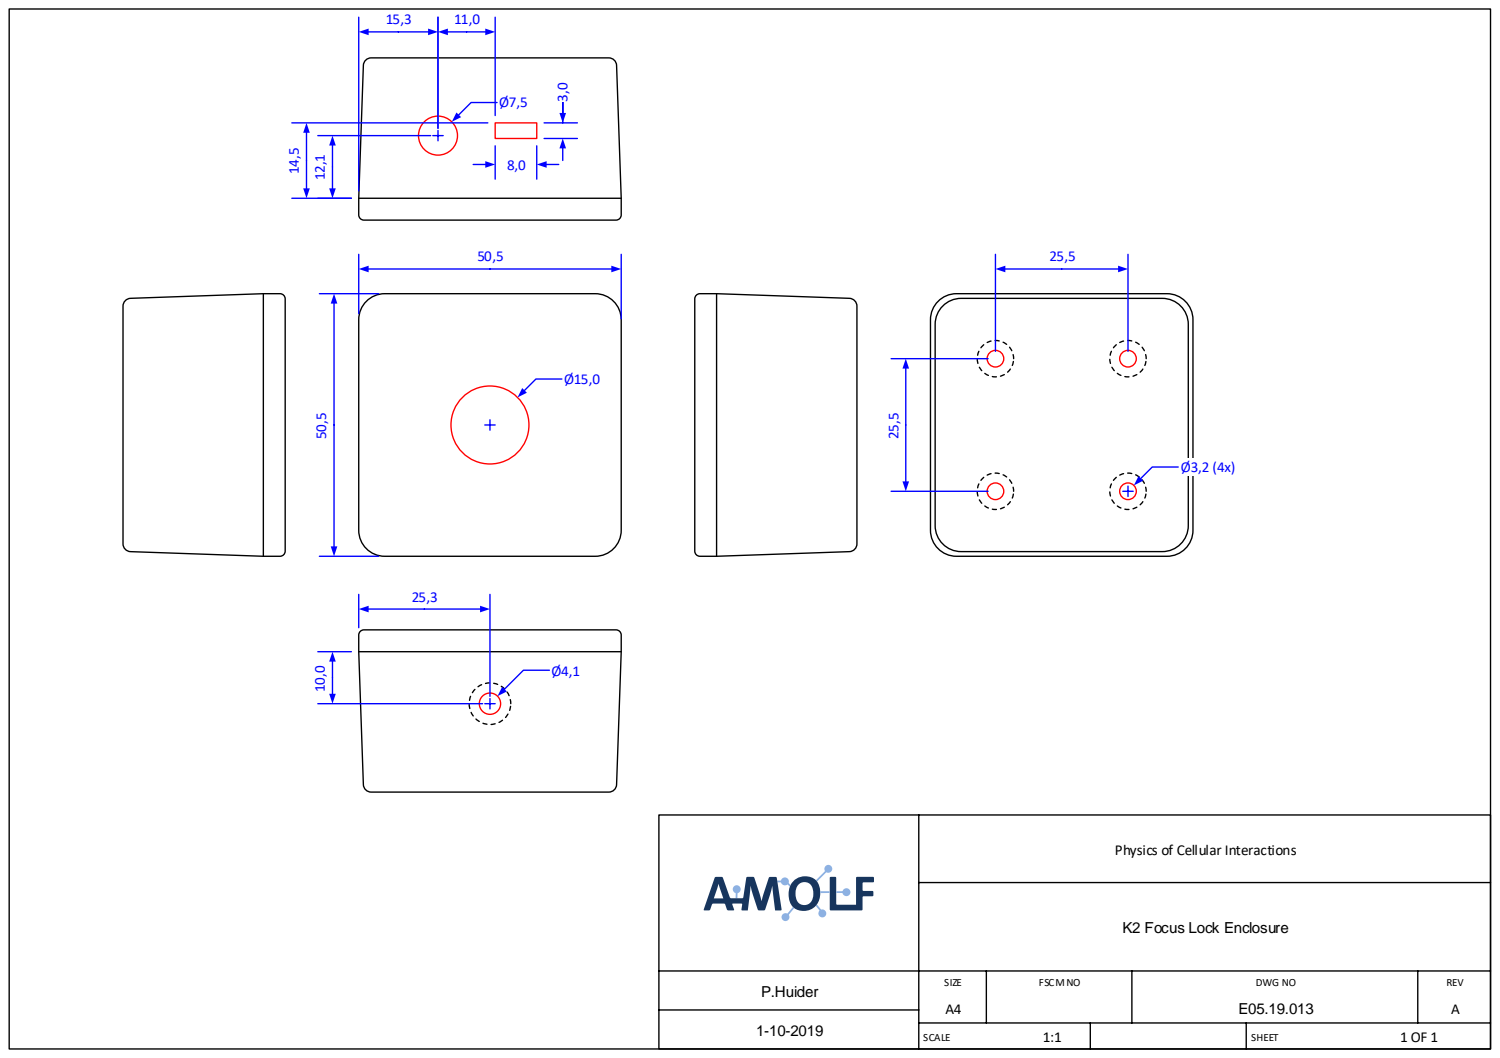
[picture p98: page 1]
SIZE; FSCM NO; DWG NO; REV; SCALE; SHEET; P.Huider

Physics of Cellular Interactions

K2 Focus Lock Enclosure
