GanzingerLab/K2TIRF/K2TIRF/drawings/sampleholder_insert_updated.pdf

A | A

# Doorsnede A-A archief 1,2

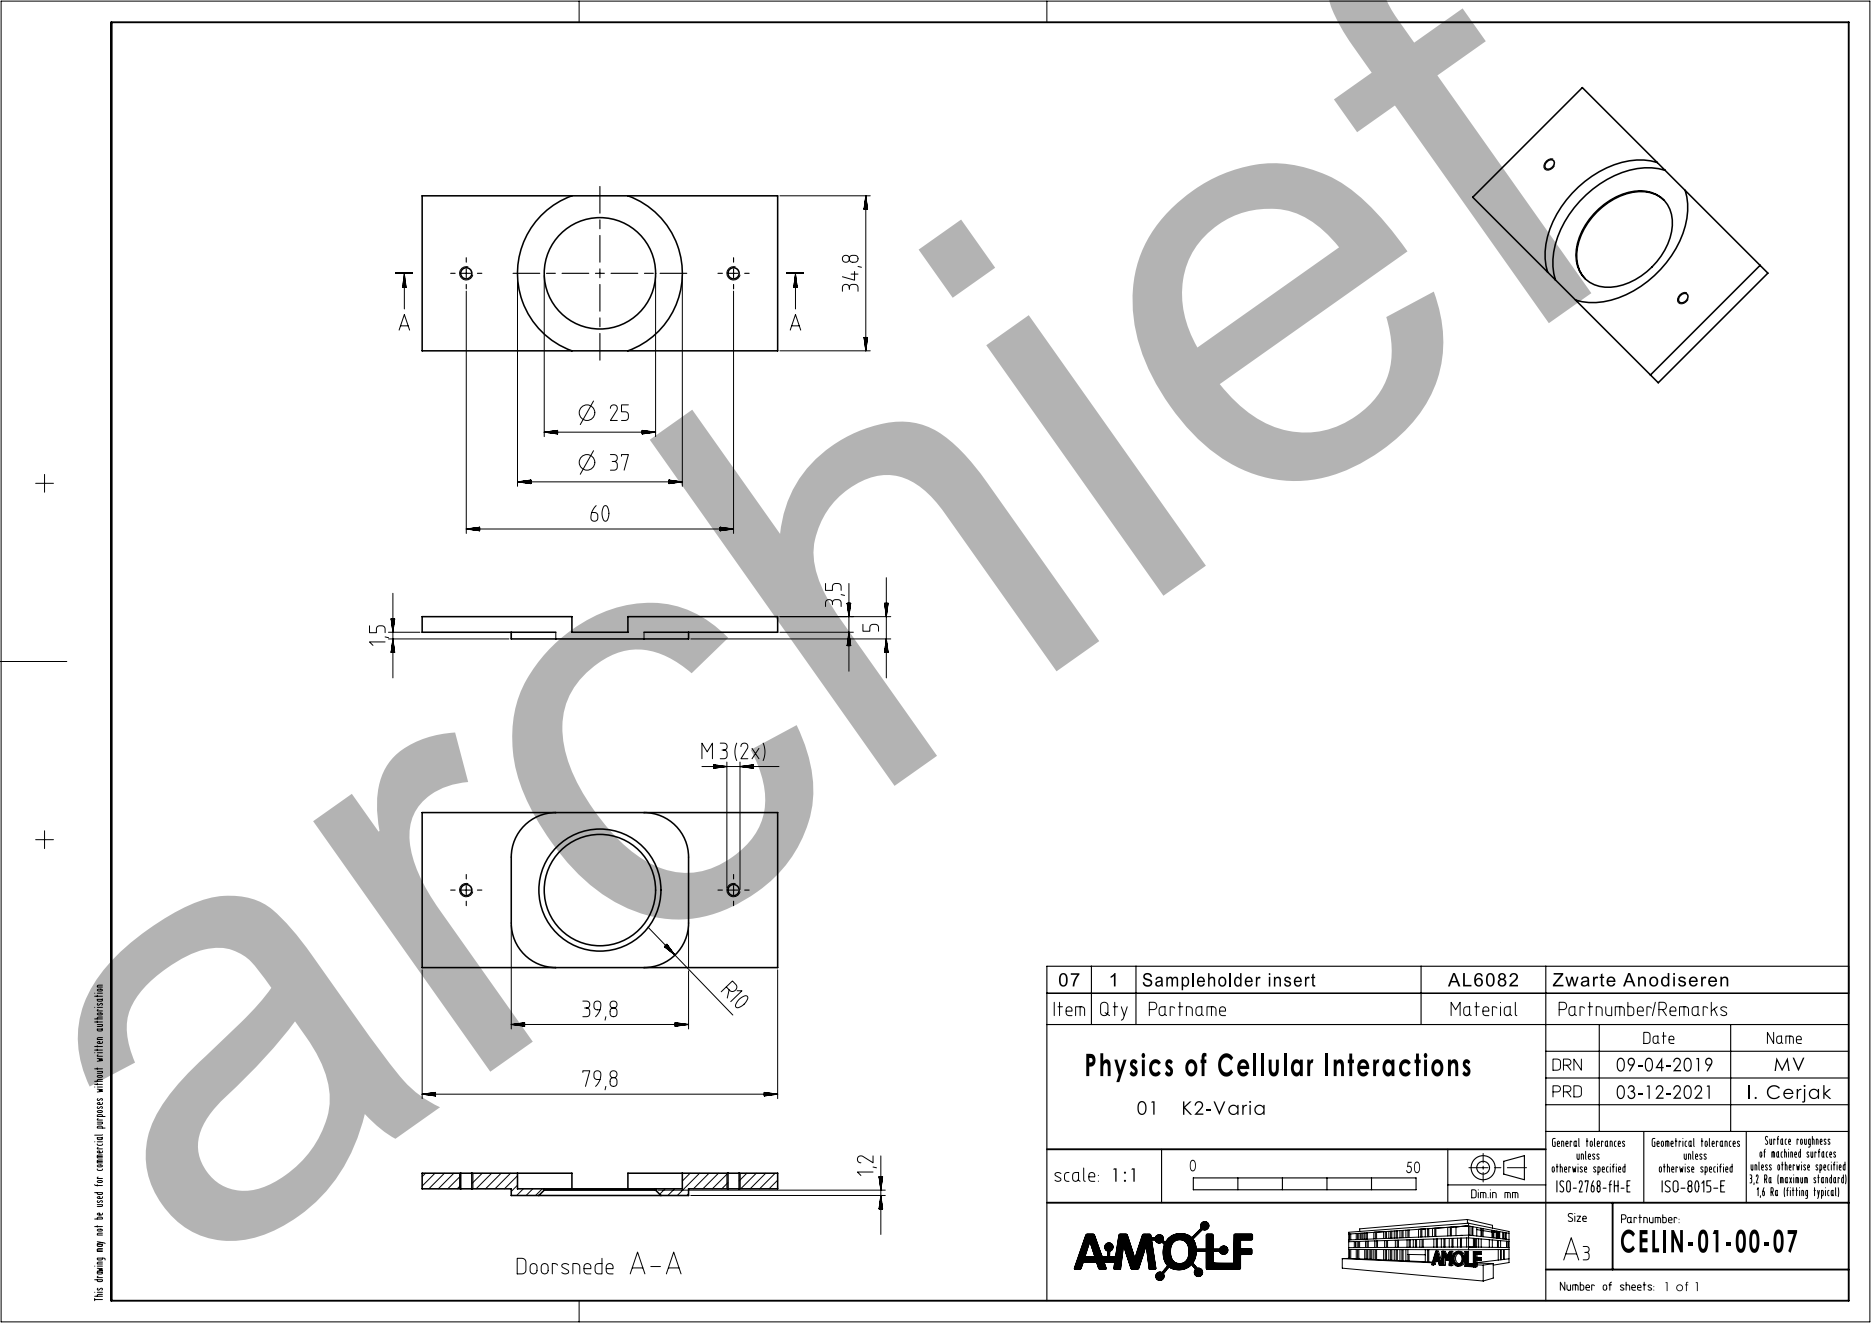
[picture p99: page 1]
Size A; Partnumber:; DRN; PRD; Date; Name; ISO-2768-fH-E; ISO-8015-E; Geometrical tolerances unless otherwise specified; General tolerances unless otherwise specified; scale:; Item Qty Partname; Material; Partnumber/Remarks; Sampleholder insert; Zwarte Anodiseren; K2-Varia; CELIN-01-00-07; I. Cerjak

Physics of Cellular Interactions

This drawing may not be used for commercial purposes without written authorisation

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

Dim.in mm

Number of sheets:
