GanzingerLab/K2TIRF/K2TIRF/drawings/sampleholder_updated.pdf

A

R4

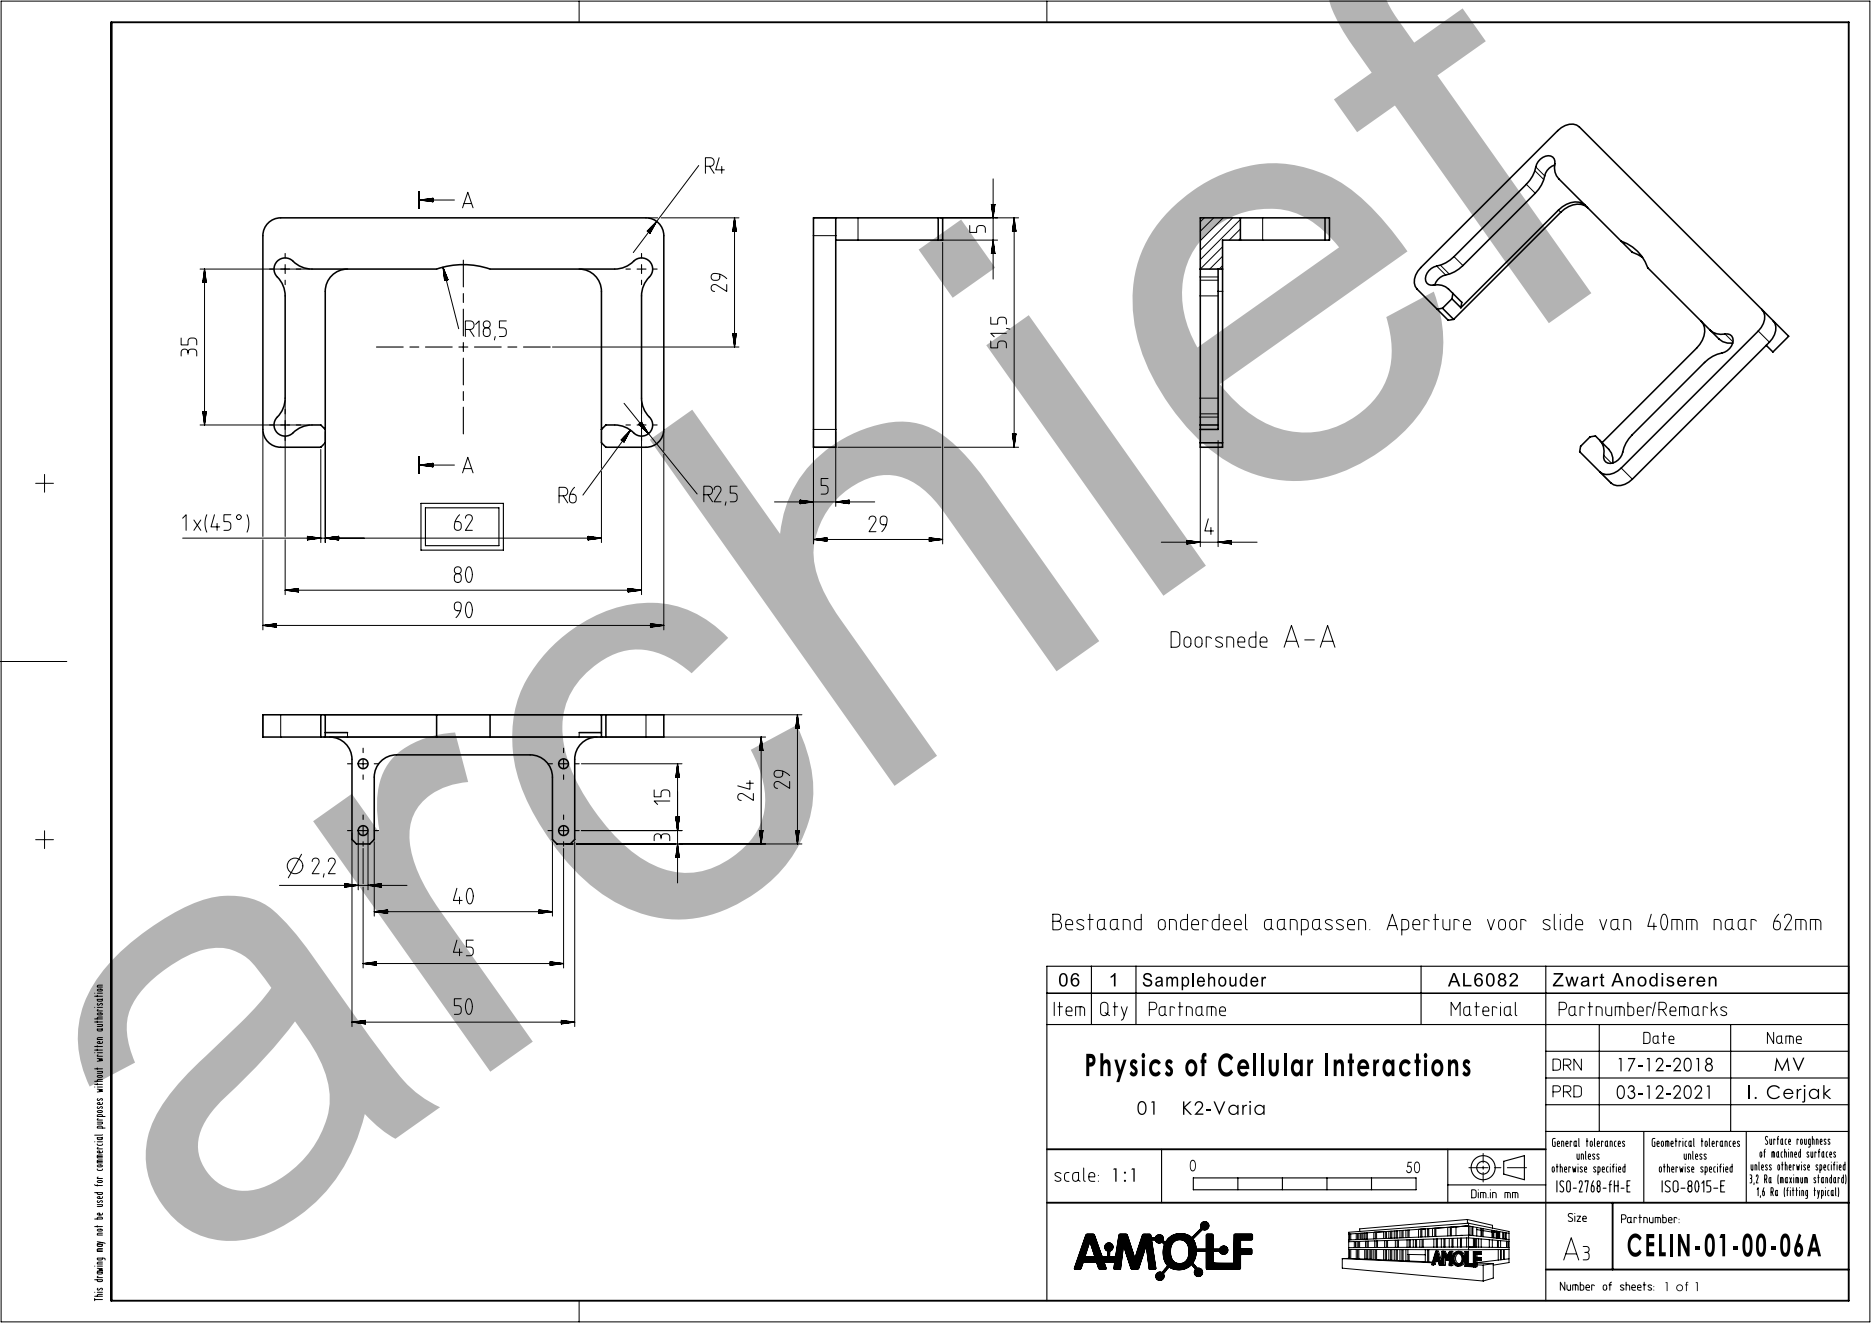
[picture p100: page 1]
Size A; Partnumber:; DRN; PRD; Date; Name; ISO-2768-fH-E; ISO-8015-E; Geometrical tolerances unless otherwise specified; General tolerances unless otherwise specified; scale:; Item Qty Partname; Material; Partnumber/Remarks; Samplehouder; Zwart Anodiseren; CELIN-01-00-06A; I. Cerjak; K2-Varia; Doorsnede A-A; archief

Bestaand onderdeel aanpassen. Aperture voor slide van 40mm naar 62mm

Physics of Cellular Interactions

This drawing may not be used for commercial purposes without written authorisation

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

Dim.in mm

Number of sheets:
