GanzingerLab/K2TIRF/K2TIRF/drawings/alignment_tool.pdf

120 (3x)

# 14 voorlopig

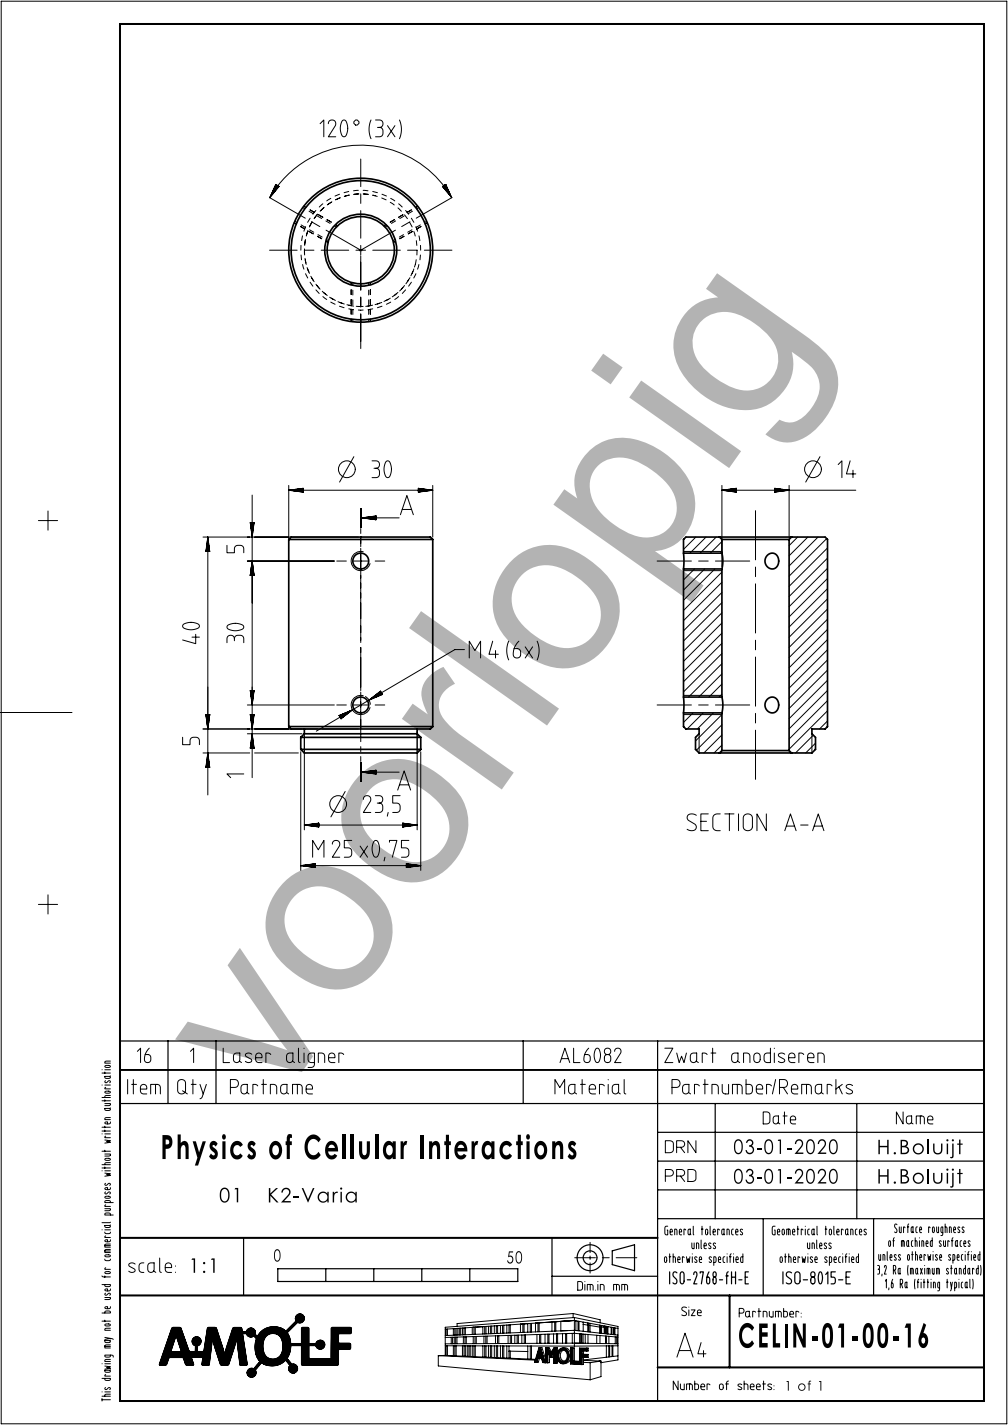
[picture p101: page 1]
Size A; Partnumber:; DRN; PRD; Date; Name; ISO-2768-fH-E; ISO-8015-E; Geometrical tolerances unless otherwise specified; General tolerances unless; otherwise specified scale:; Item Qty Partname; Material; Partnumber/Remarks; Laser aligner; Zwart anodiseren; CELIN-01-00-16; H.Boluijt; K2-Varia; SECTION A-A

Physics of Cellular Interactions

This drawing may not be used for commercial purposes without written authorisation

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

Dim.in mm

Number of sheets:
