GanzingerLab/K2TIRF/K2TIRF/drawings/housing_basis.pdf

16

6

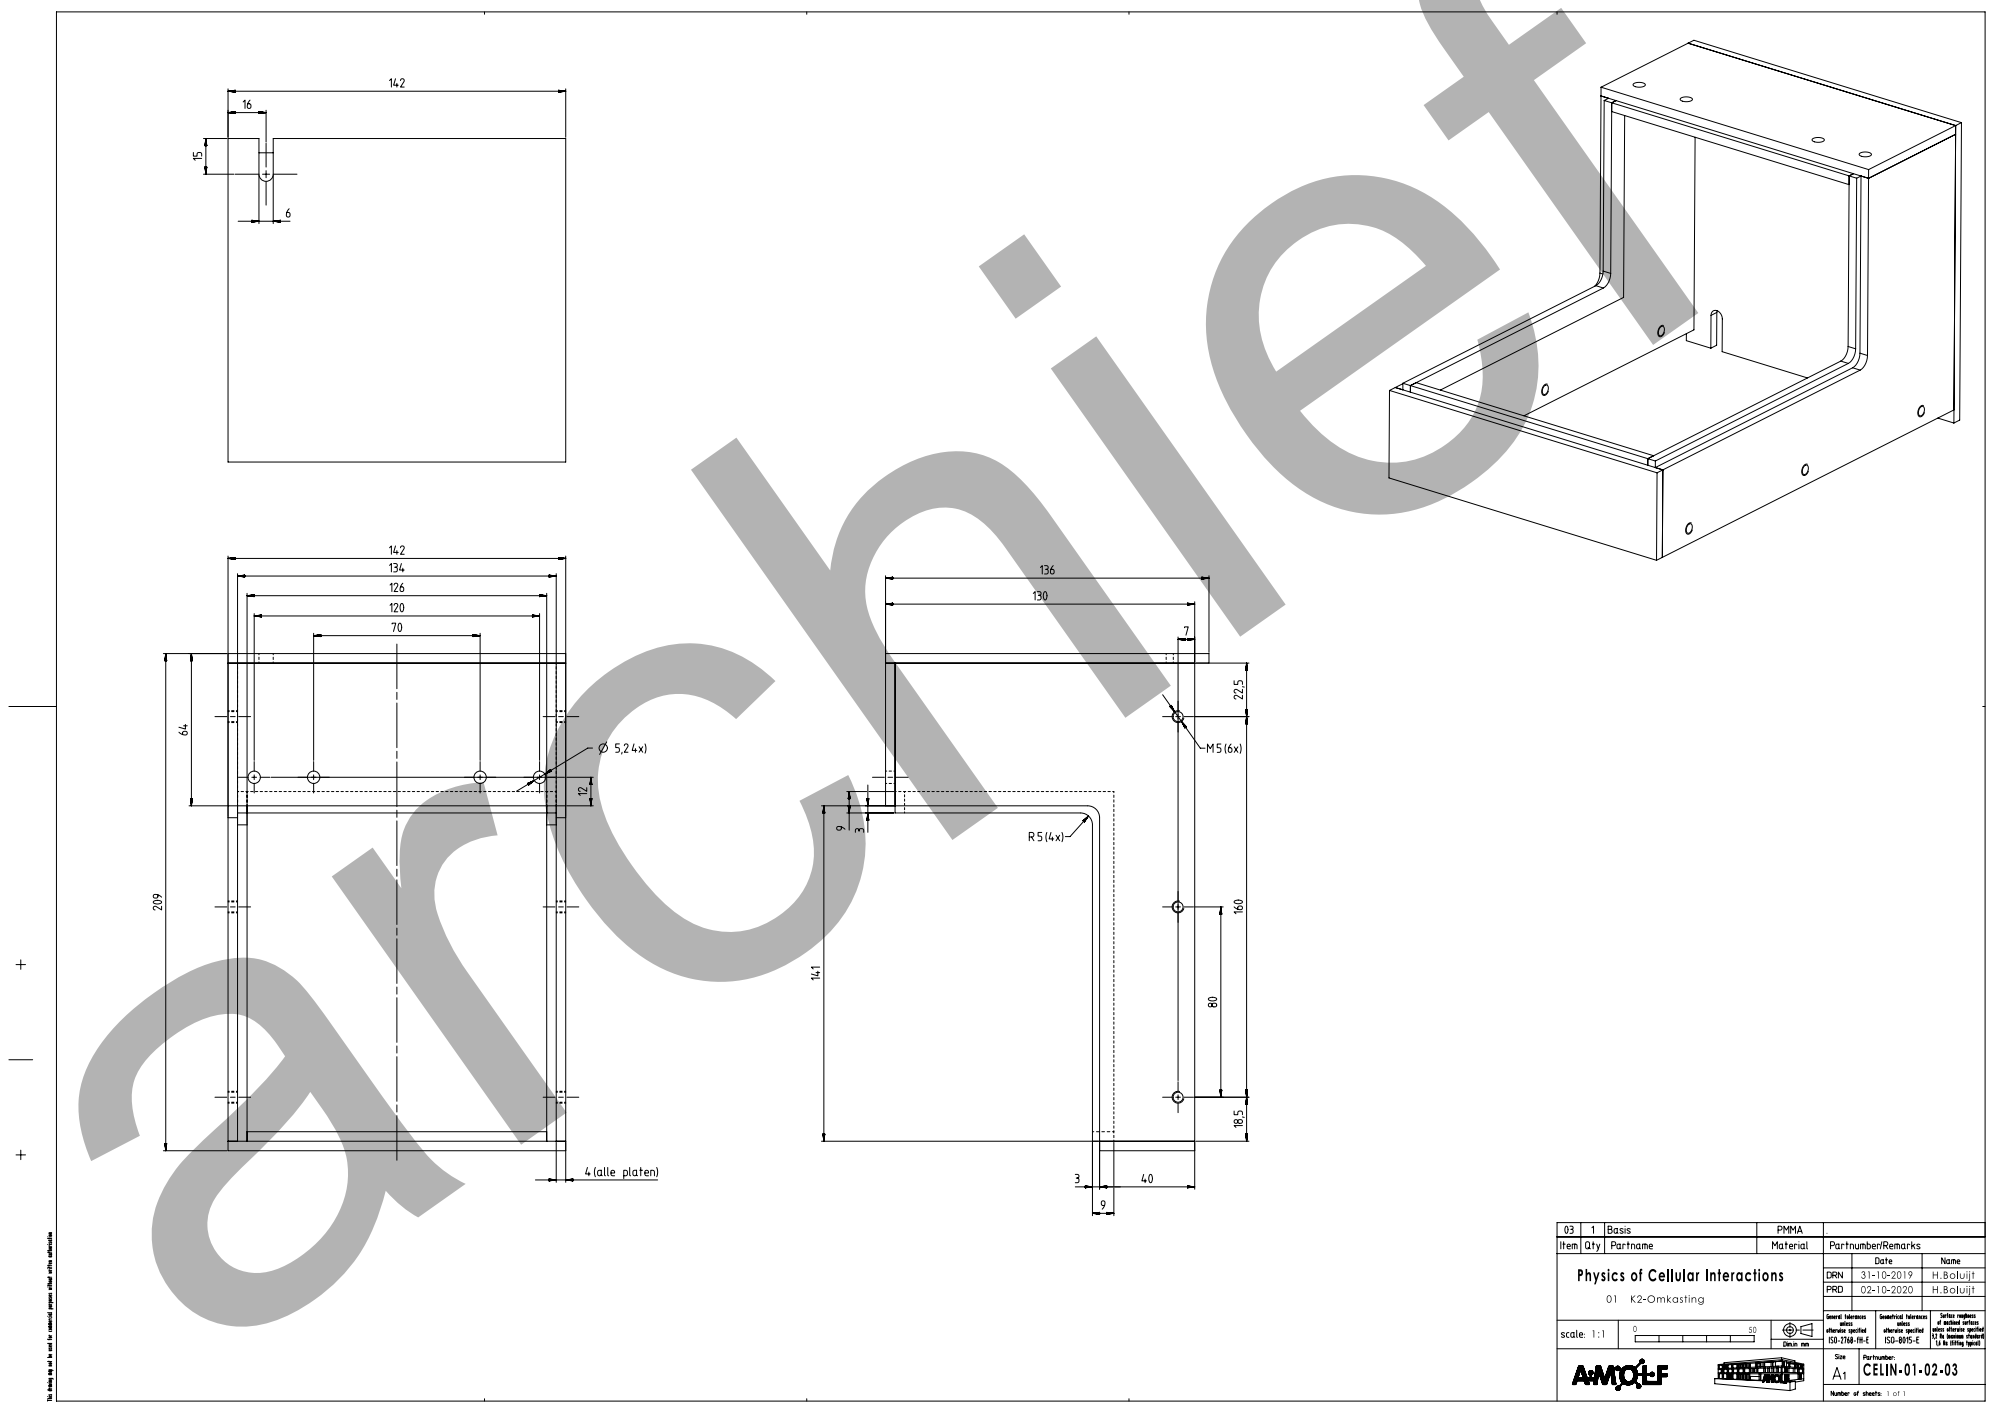
[picture p102: page 1]
Size A; Partnumber:; DRN; PRD; Date; Name; ISO-2768-fH-E; ISO-8015-E; Geometrical tolerances unless otherwise specified; General tolerances unless otherwise specified; scale:; Item Qty Partname; Material; Partnumber/Remarks; Basis; PMMA; CELIN-01-02-03; H.Boluijt; Physics of Cellular Interactions; K2-Omkasting; 4 (alle platen); 40 archief

This drawing may not be used for commercial purposes without written authorisation

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

Dim.in mm

Number of sheets:
