GanzingerLab/K2TIRF/K2TIRF/drawings/aperture.pdf

# 05 archief

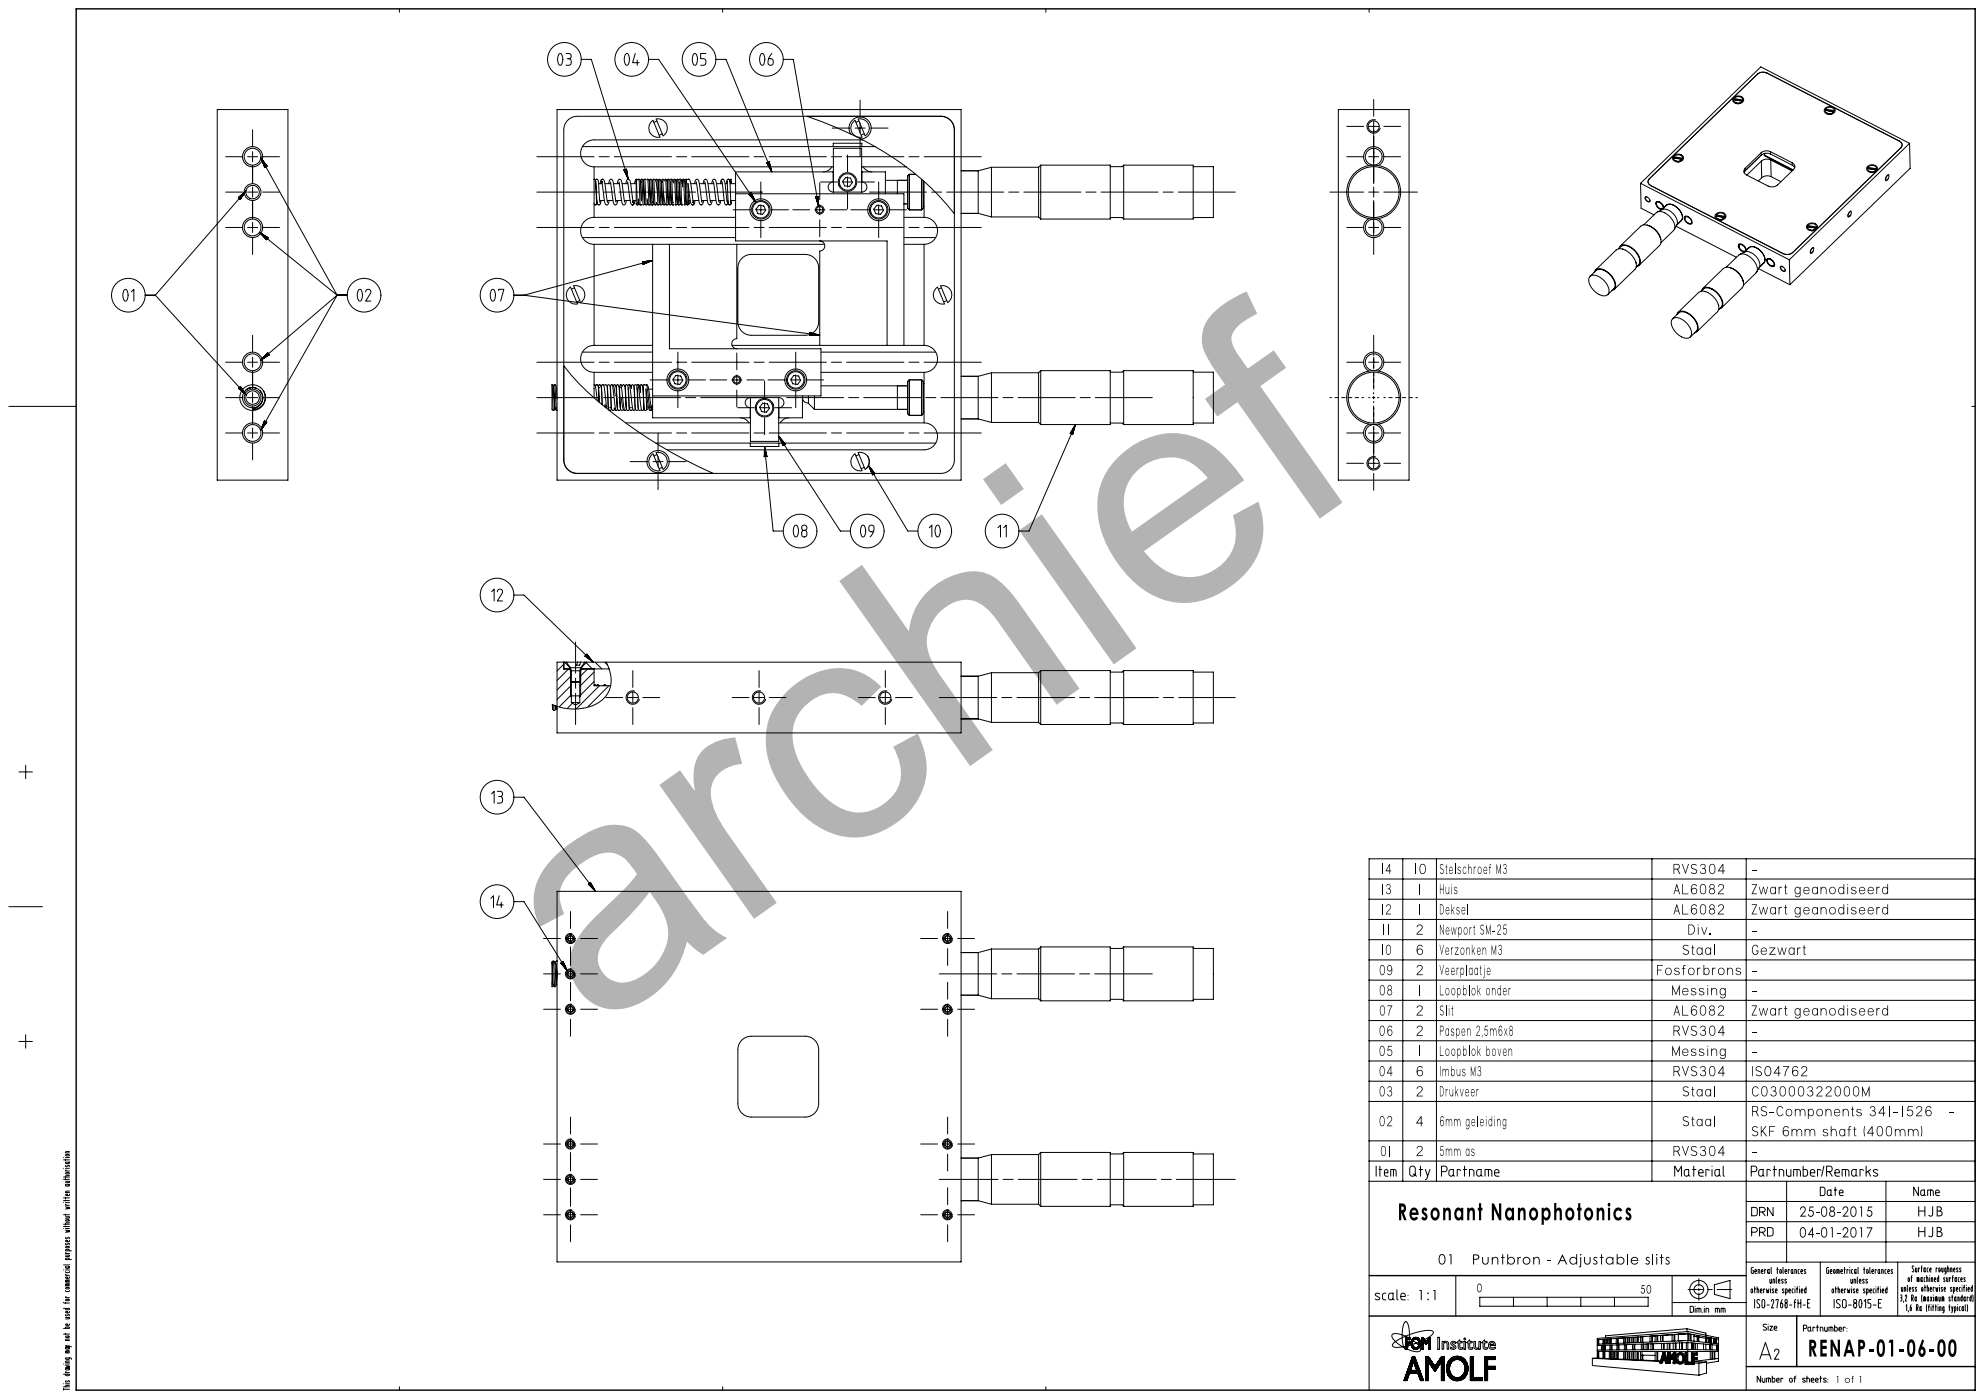
[picture p103: page 1]
Size A; Partnumber:; DRN; PRD; Date; Name; ISO-2768-fH-E; ISO-8015-E; Geometrical tolerances unless otherwise specified; General tolerances unless otherwise specified; scale:; 10 Stelschroef M3; RVS304; Huis; Zwart geanodiseerd; Deksel; 2 Newport SM-25; Div.; 6 Verzonken M3; Staal; Gezwart; 2 Veerplaatje; Fosforbrons; Loopblok onder; Messing; 2 Slit; 2 Paspen 2,5m6x8; Loopblok boven; Imbus M3; ISO4762; 2 Drukveer; 4 6mm geleiding; RS-Components 341-1526 - SKF 6mm shaft (400mm)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

This drawing may not be used for commercial purposes without written authorisation

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

Dim.in mm

Number of sheets:
