GanzingerLab/K2TIRF/K2TIRF/drawings/cover.pdf

B

# Potgaten om magneten in te lijmen

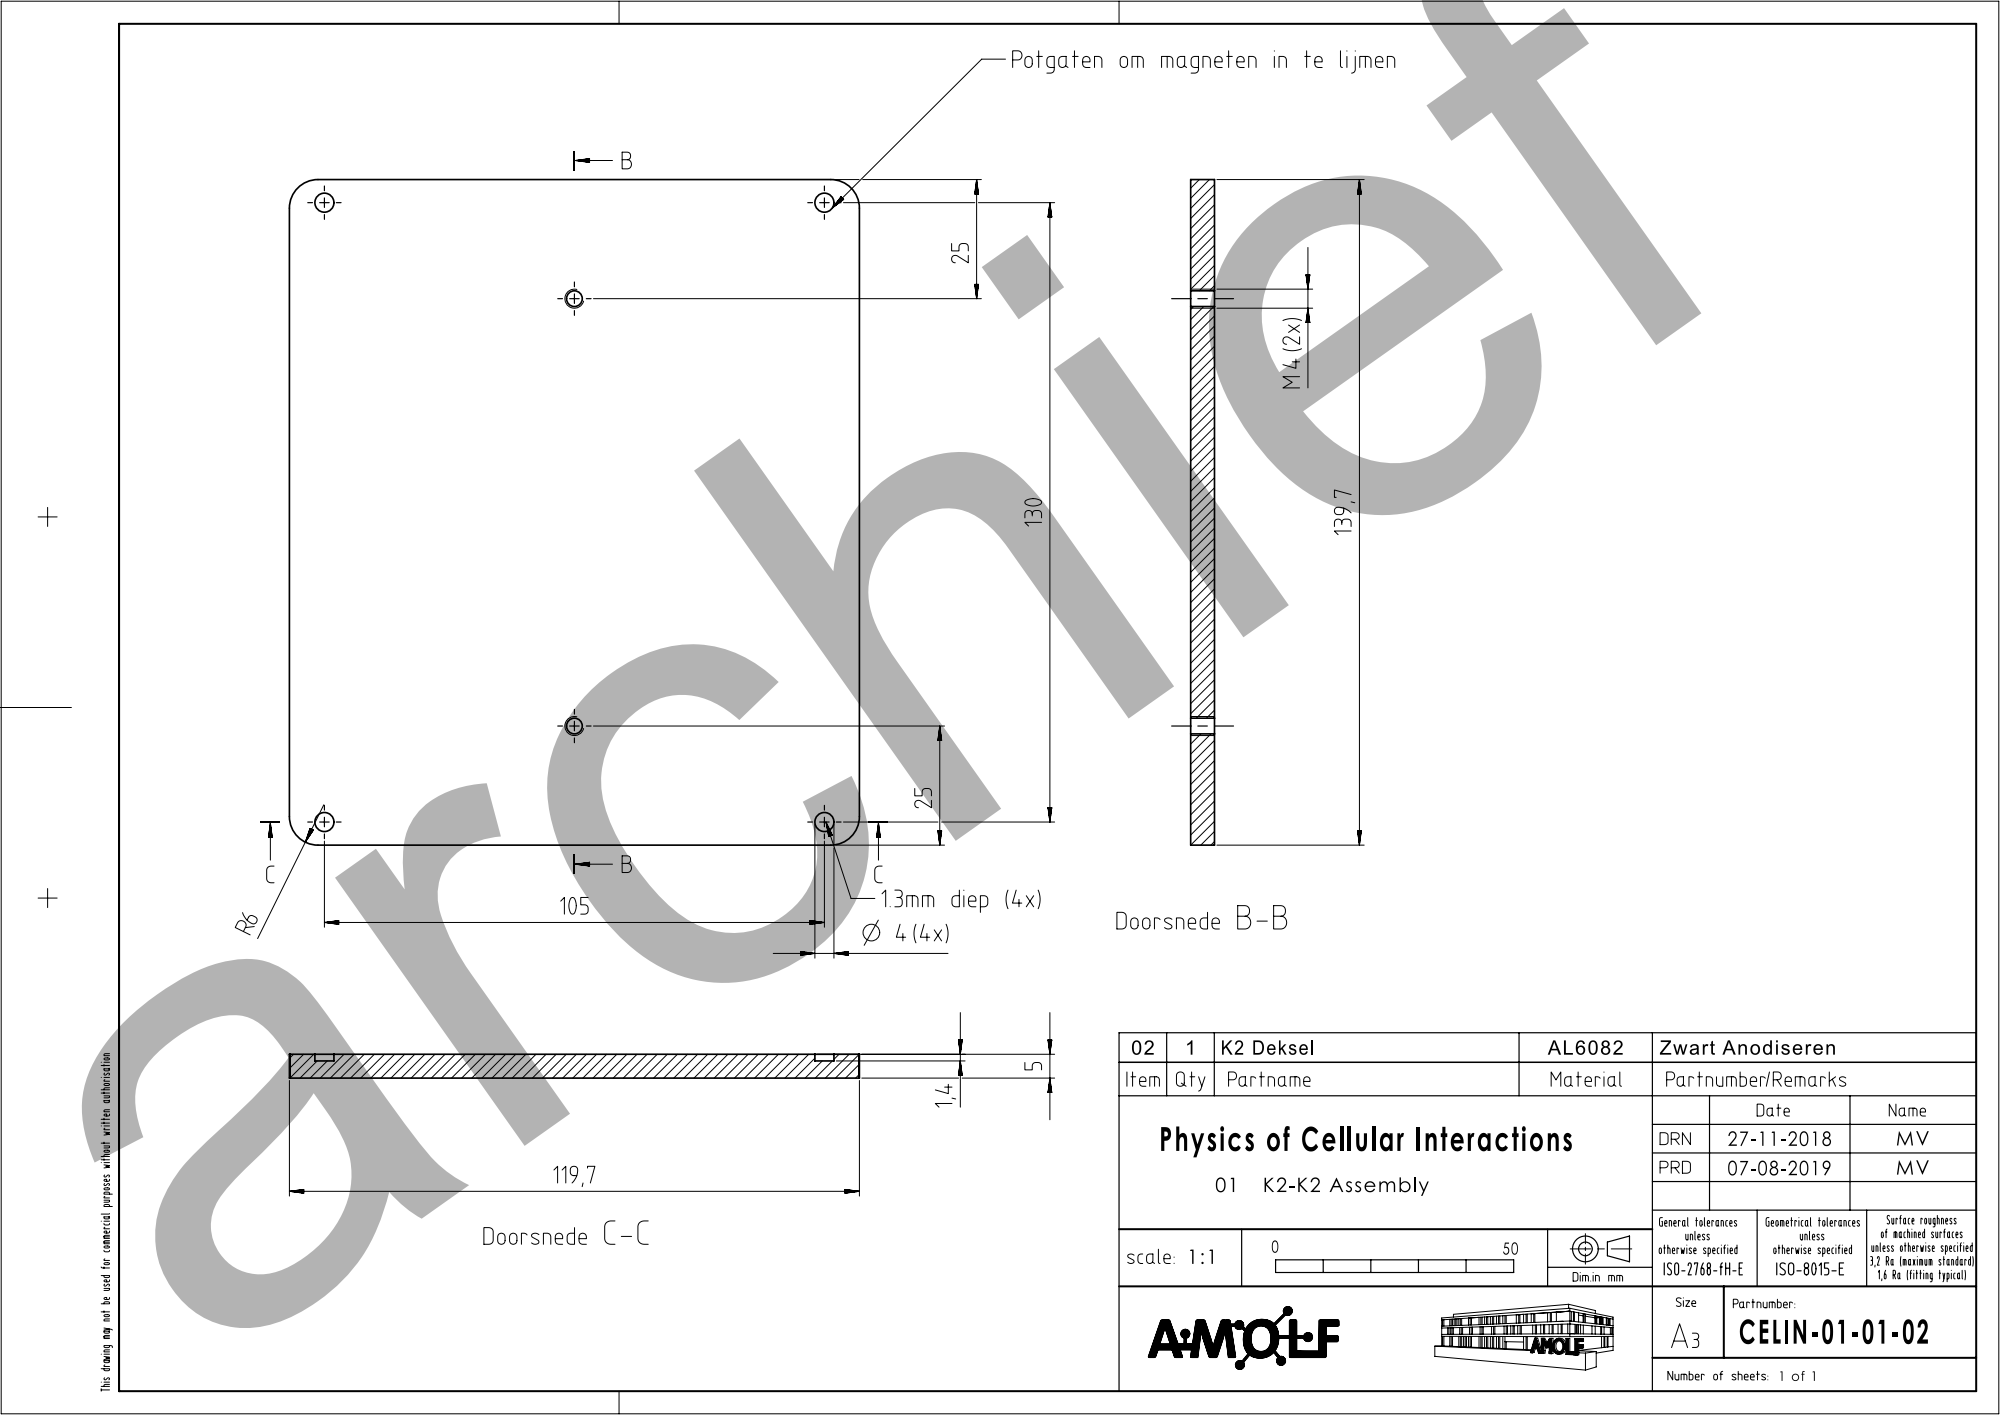
[picture p104: page 1]
Size A; Partnumber:; DRN; PRD; Date; Name; ISO-2768-fH-E; ISO-8015-E; Geometrical tolerances unless otherwise specified; General tolerances unless otherwise specified; scale:; Item Qty Partname; Material; Partnumber/Remarks; K2 Deksel; Zwart Anodiseren; Physics of Cellular Interactions; K2-K2 Assembly; CELIN-01-01-02; Doorsnede B-B; Doorsnede C-C; 1.3mm diep (4x) archief

This drawing may not be used for commercial purposes without written authorisation

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

Dim.in mm

Number of sheets:
