GanzingerLab/K2TIRF/K2TIRF/documentation/qgFocus/Focus Lock - Design_v1.0.pdf

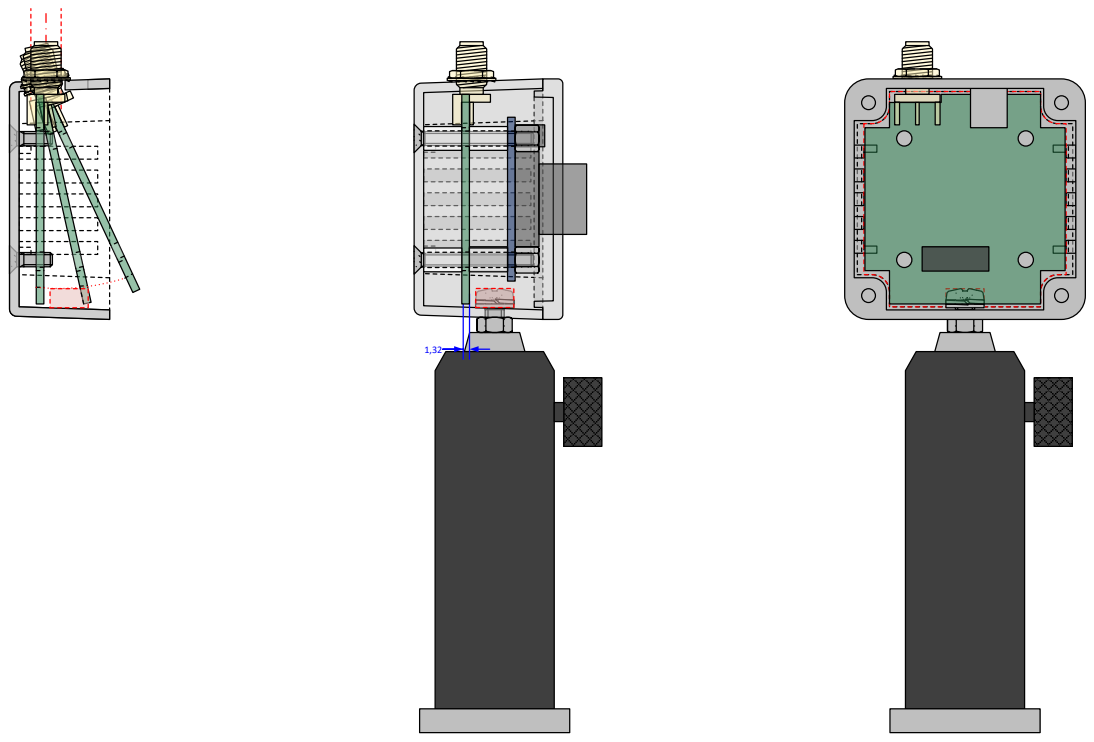
[picture p105: page 1]
K2 Focus Lock; SIZE; FSCM NO; DWG NO; REV; SCALE; SHEET; P.Huider

Physics of Cellular Interactions

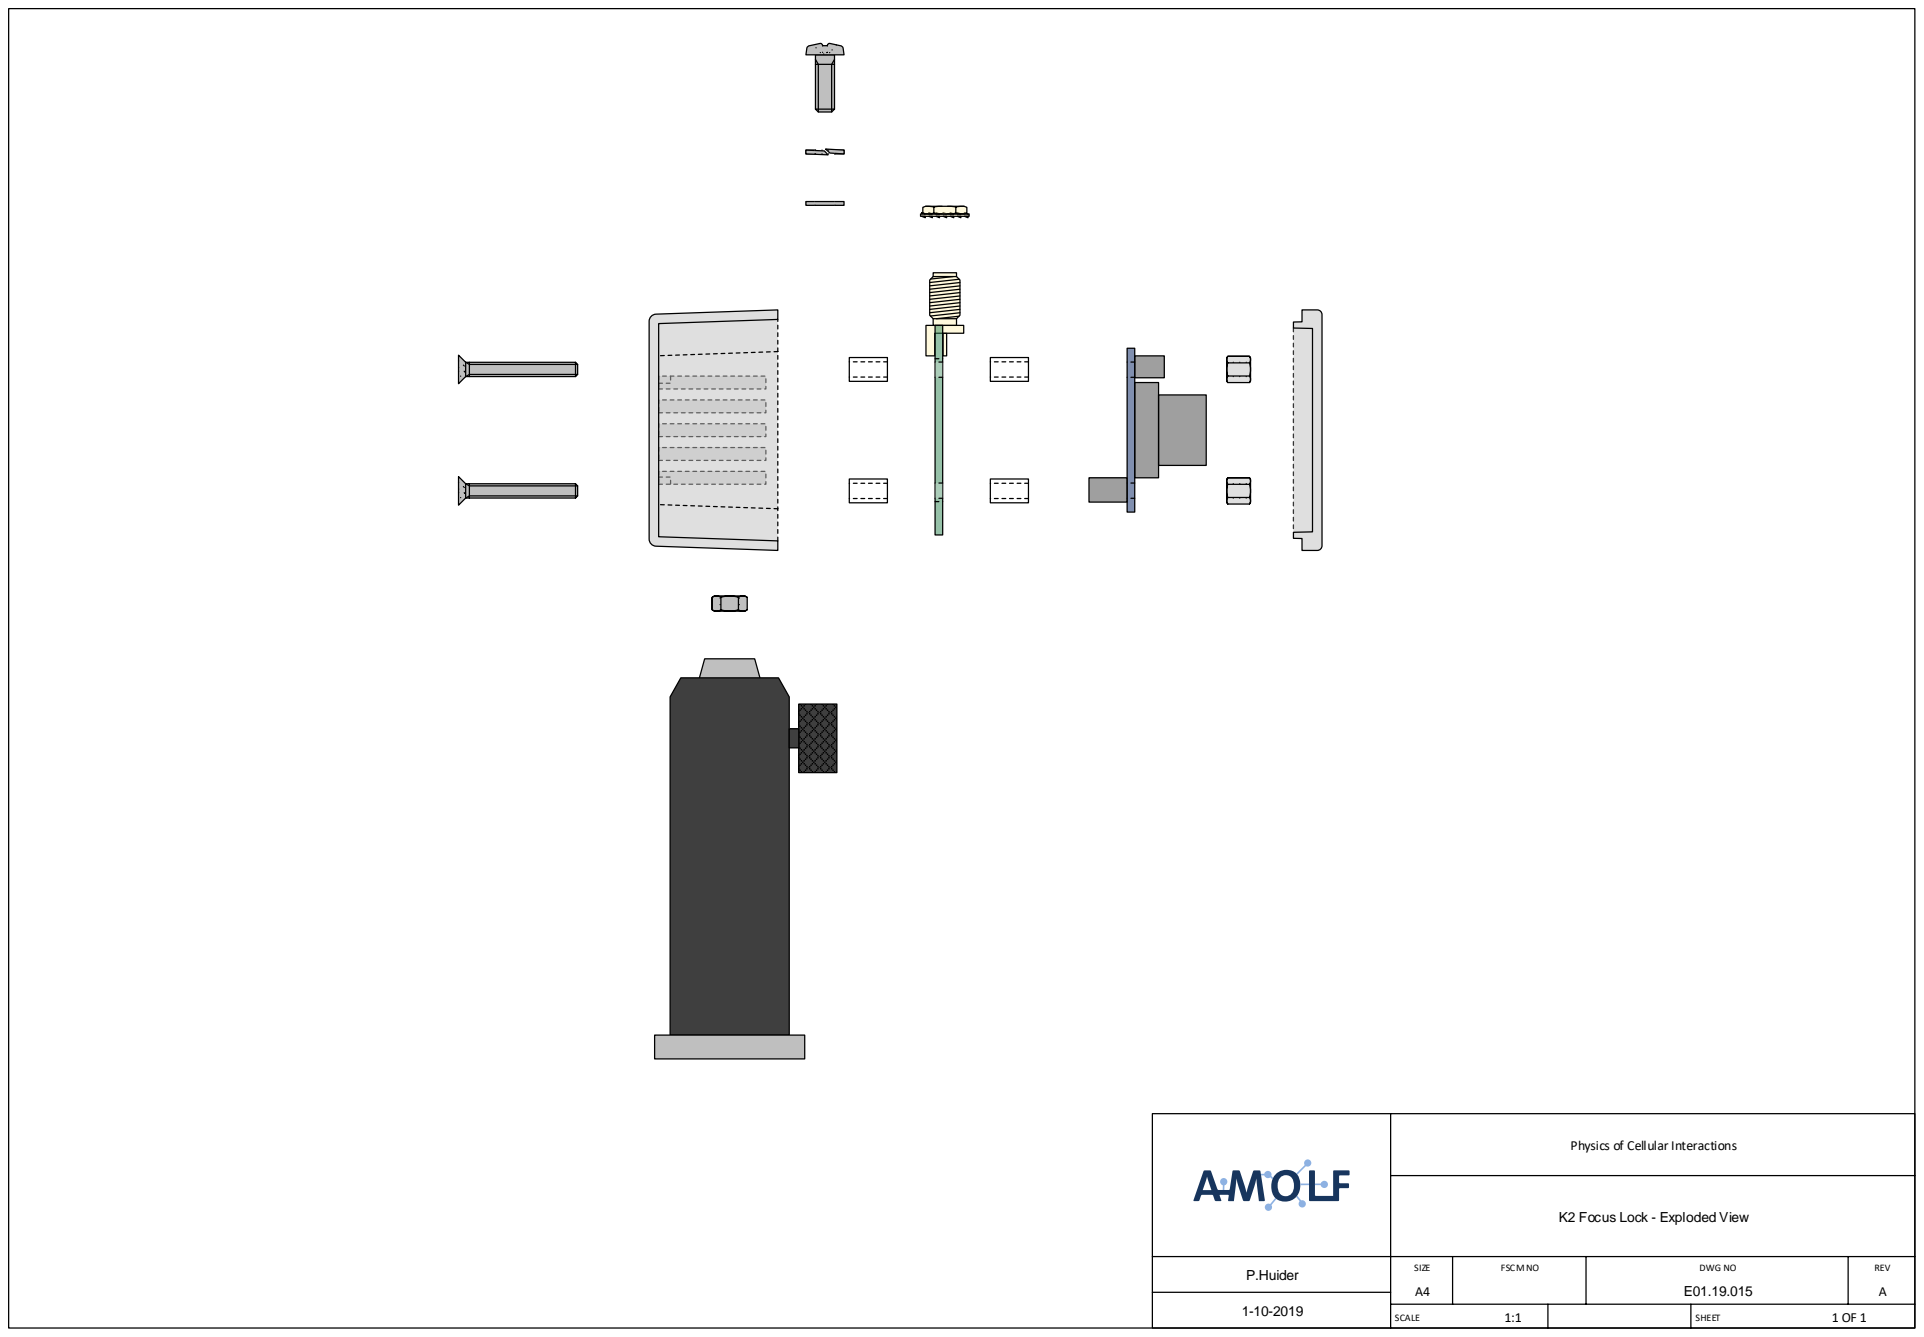
[picture p106: page 2]
SIZE; FSCM NO; DWG NO; REV; SCALE; SHEET; P.Huider

Physics of Cellular Interactions

K2 Focus Lock - Exploded View
