GanzingerLab/K2TIRF/K2TIRF/drawings/cube.pdf

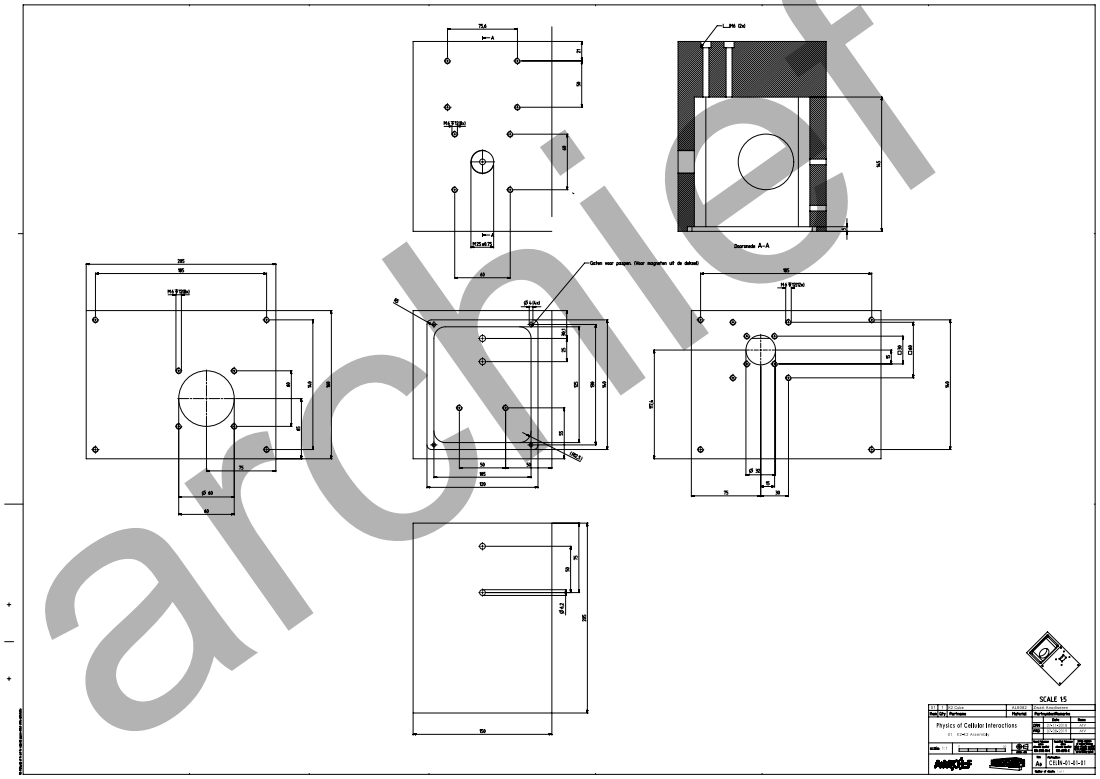
[picture p107: page 1]
archief
