GanzingerLab/K2TIRF/K2TIRF/drawings/kmts25e_adapter.pdf

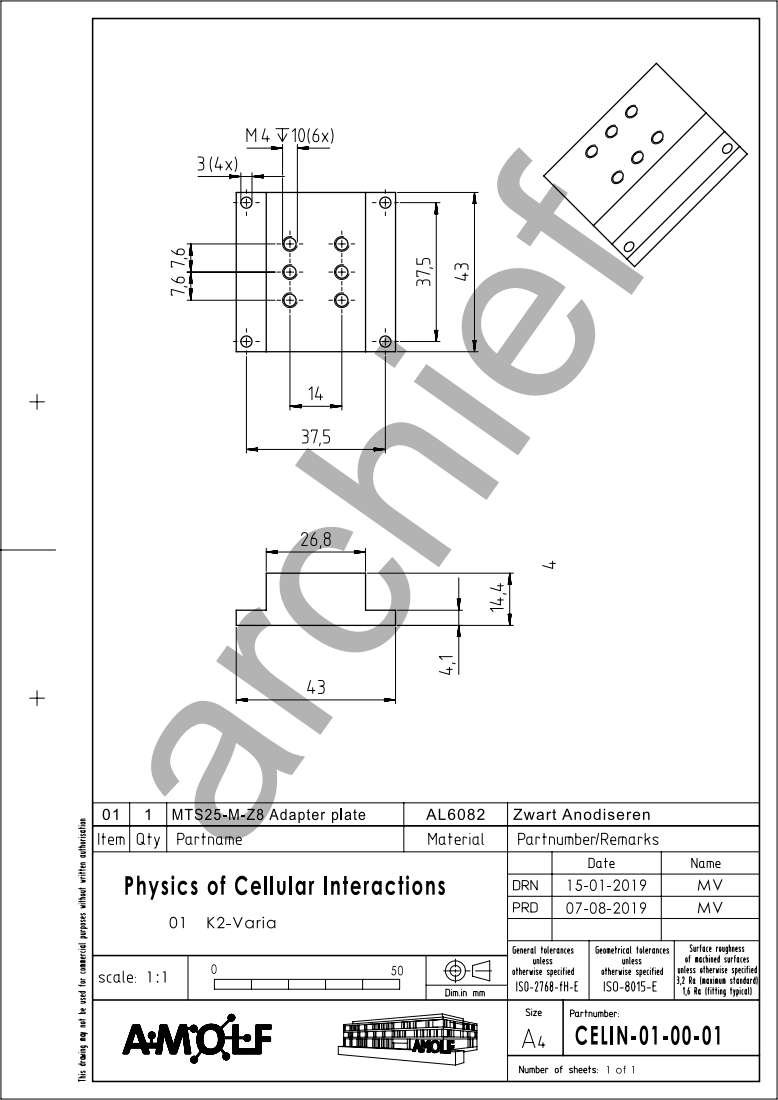
[picture p108: page 1]
archief
