GanzingerLab/K2TIRF/K2TIRF/drawings/thermal_spacer.pdf

A | A

# VIEW B

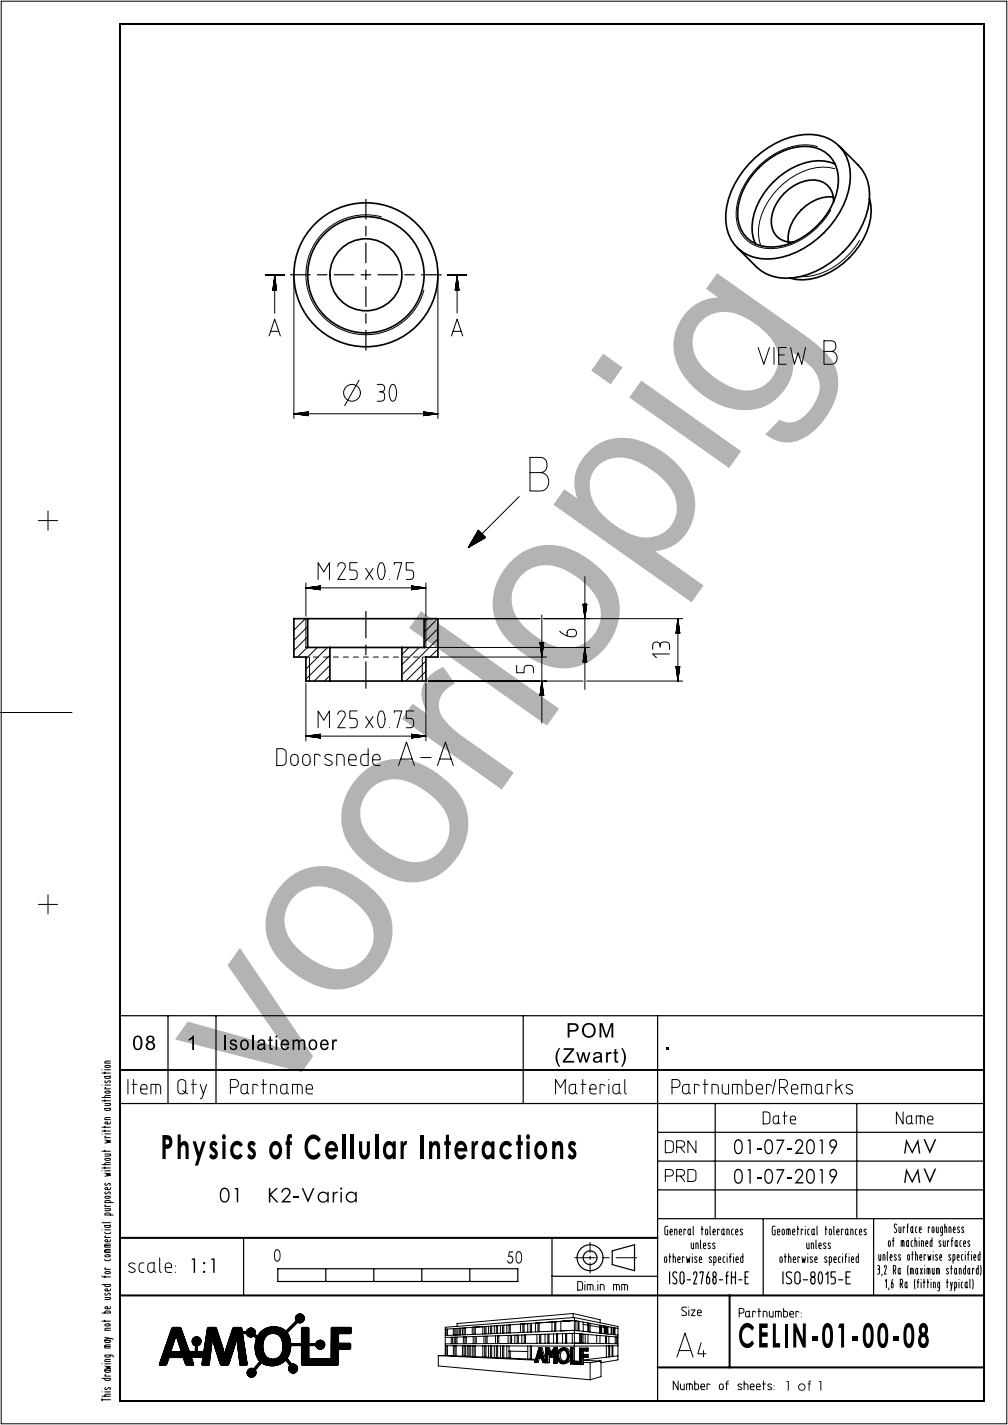
[picture p109: page 1]
Size A; Partnumber:; DRN; PRD; Date; Name; ISO-2768-fH-E; ISO-8015-E; Geometrical tolerances unless otherwise specified; General tolerances unless; otherwise specified scale:; Item Qty Partname; Material; Partnumber/Remarks; Isolatiemoer; POM; (Zwart); Physics of Cellular Interactions; K2-Varia; CELIN-01-00-08; Doorsnede A-A; voorlopig

This drawing may not be used for commercial purposes without written authorisation

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

Dim.in mm

Number of sheets:
