GanzingerLab/K2TIRF/K2TIRF/documentation/qgFocus/E03_18_023_K2FocusLock_pcb Hammond 1590LLBBK.pdf

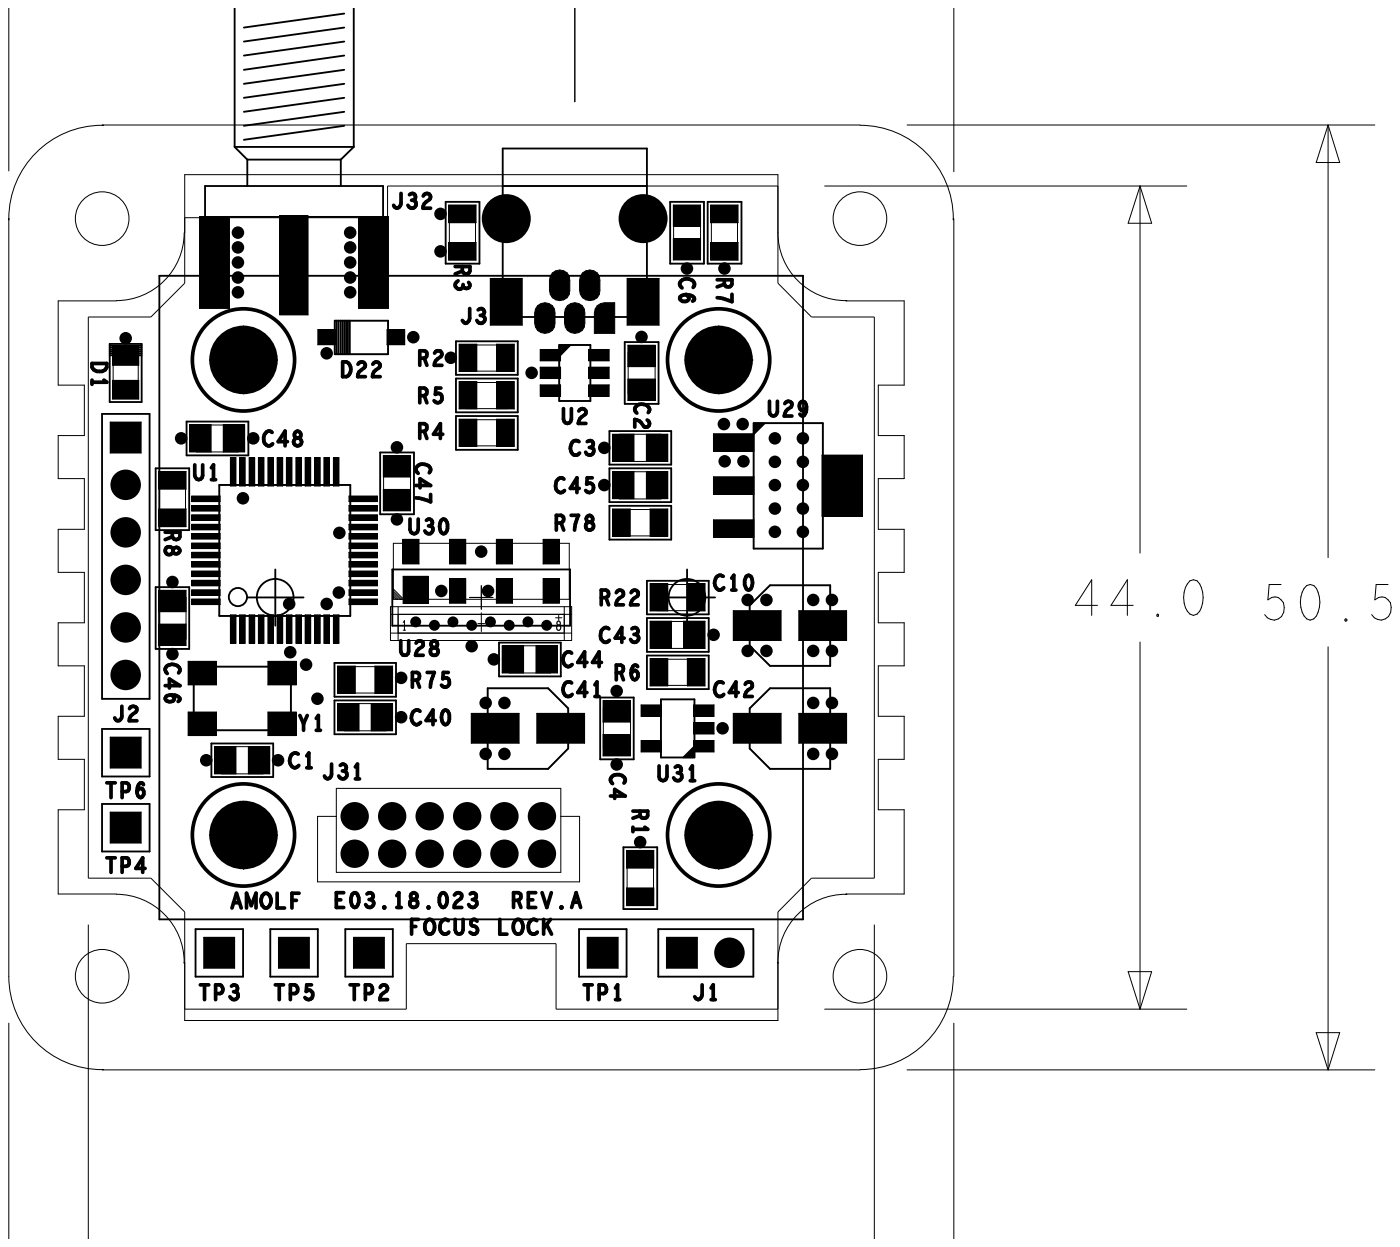
[picture p110: page 1]
