GanzingerLab/K2TIRF/K2TIRF/documentation/qgFocus/E03.18.0023_K2_FocusLock.ioc

Mcu.UserName=STM32F303CBTx
PA0.GPIO_Label=TIM2_aquisition
PA0.Signal=S_TIM2_CH1_ETR
PA1.GPIO_Label=ADC1_sensor_AO
PA1.Signal=ADC1_IN2
PA10.Signal=S_TIM1_CH3
PA11.Signal=USB_DM
PA12.Signal=USB_DP
PA13.Signal=SYS_JTMS-SWDIO
PA14.Signal=SYS_JTCK-SWCLK
PA4.GPIO_Label=DAC1_sensor_monitor
PA4.Signal=COMP_DAC1_group
PA6.GPIO_Label=TIM3_sensor_SI
PA6.Signal=S_TIM3_CH1
PA8.GPIO_Label=TIM1_sensor_CLK
PA8.Signal=S_TIM1_CH1
PA9.GPIO_Label=TIM1_CLK_monitor
PA9.Signal=S_TIM1_CH2
PF0-OSC_IN.Signal=RCC_OSC_IN
