GanzingerLab/K2TIRF/(commit log)

2020-10-21 qgfocus doc
    [qgFocus_components.xlsx]
2021-01-25 added gelimager filter
2022-03-07 dovetail translation stages added
2022-11-16 added K2 scripts
    laser calibration/verification, xy grid and z loop scripts
2022-12-23 sampleholdler updated
2022-12-23 samples png
